jounshenwang/land-air-robot/模型/README.md

# -
面向复杂光伏电站环境，设计集地面行走、空中飞行、组件清洁与红外巡检于一体的陆空两栖机器人。采用陆空复用变构结构，结合PX4、ROS 2及Mid-360激光雷达，基于Nav2实现地面自主导航，基于3D A*实现空中路径规划，提升机器人在复杂环境下的通行与作业能力。
