jounshenwang/land-air-robot/模型/60_16碳纤维管子.SLDPRT

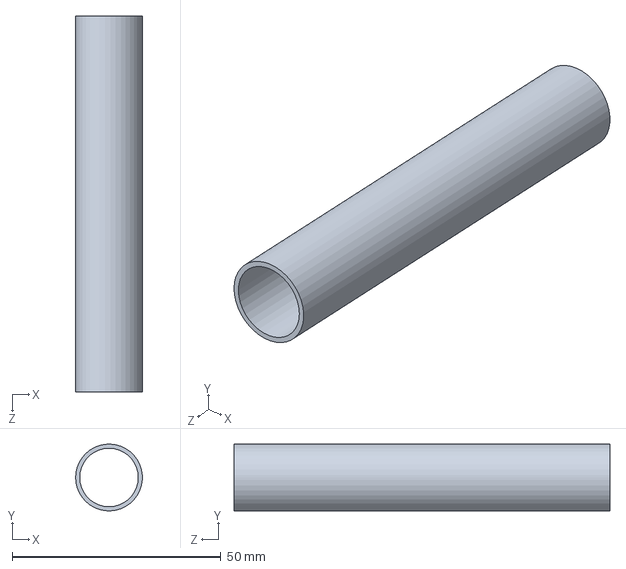
[picture p15: CAD file, 2026-11-09]
模型/60_16碳纤维管子.SLDPRT
16.0 x 16.0 x 90.0 mm
