jounshenwang/land-air-robot/模型/机臂舵机连接.SLDPRT

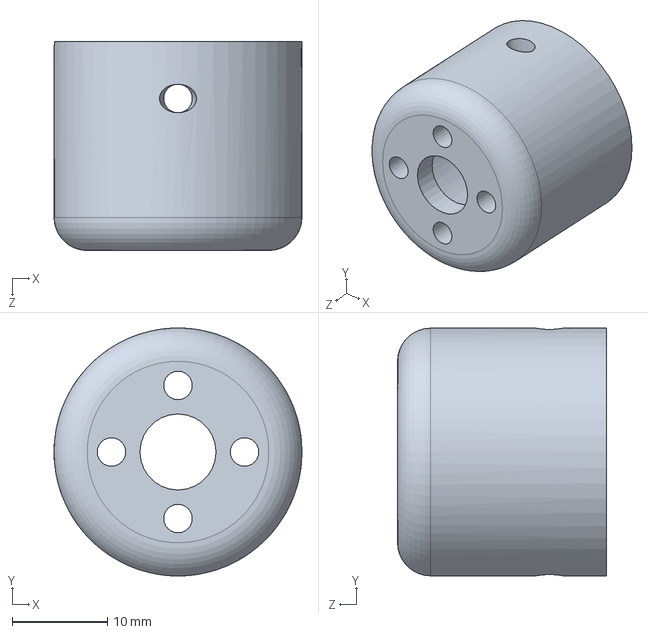
[picture p16: CAD file, 2026-11-09]
模型/机臂舵机连接.SLDPRT
26.1 x 26.1 x 22.0 mm
