jounshenwang/land-air-robot/模型/上脚架.SLDPRT

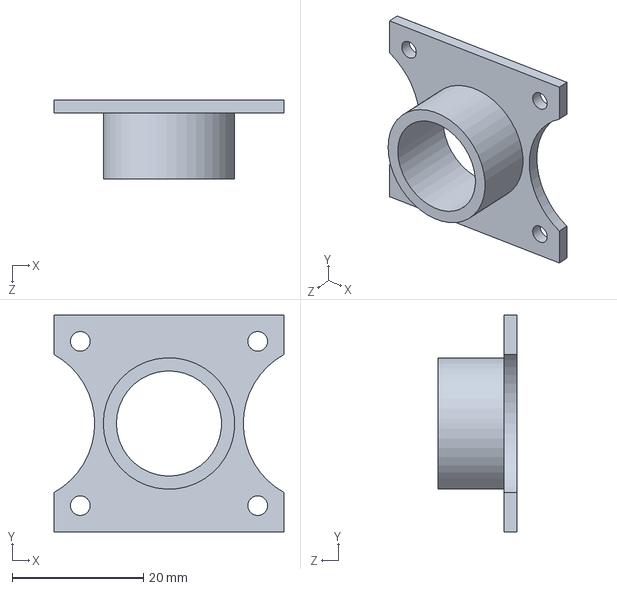
[picture p17: CAD file, 2026-11-09]
模型/上脚架.SLDPRT
35.0 x 33.0 x 12.0 mm
