jounshenwang/land-air-robot/模型/快拆结构.SLDPRT

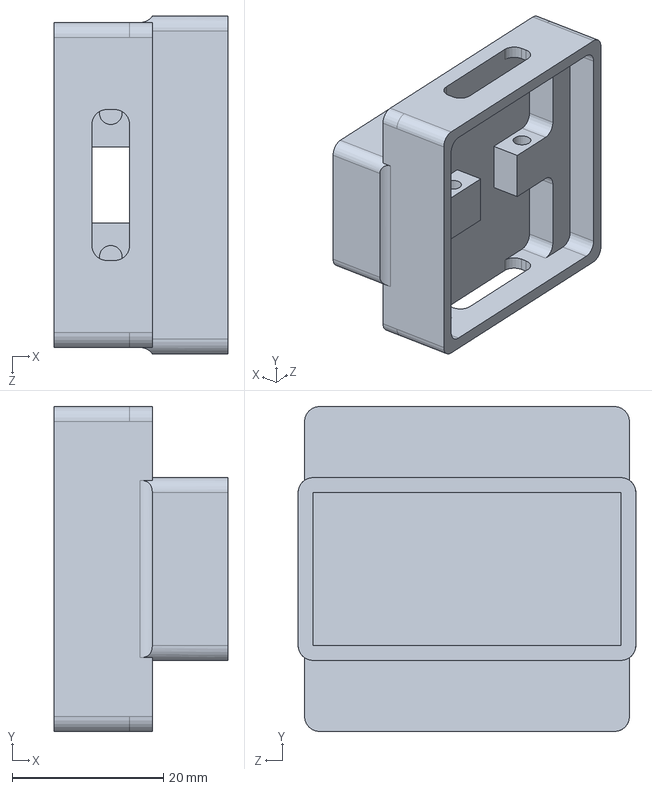
[picture p18: CAD file, 2026-11-09]
模型/快拆结构.SLDPRT
23.0 x 43.0 x 44.7 mm
