jounshenwang/land-air-robot/模型/减速电机底座.SLDPRT

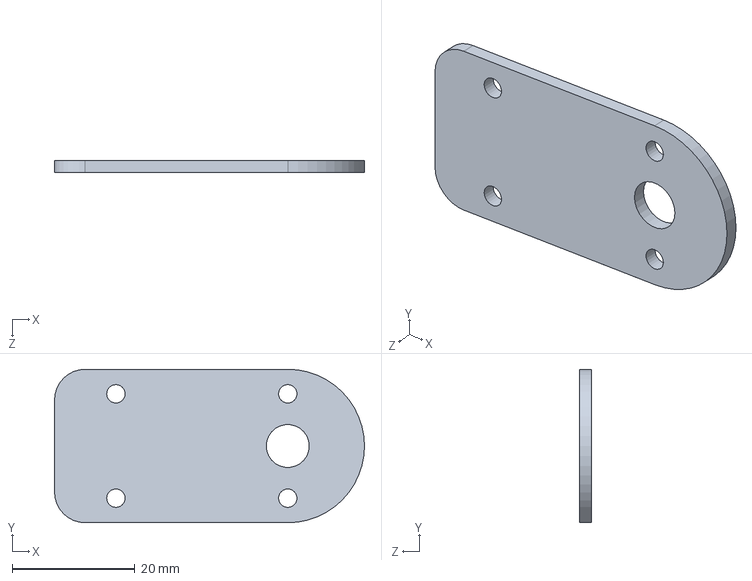
[picture p19: CAD file, 2026-11-09]
模型/减速电机底座.SLDPRT
50.5 x 25.0 x 2.00 mm
