jounshenwang/land-air-robot/模型/11寸桨电机底座.SLDPRT

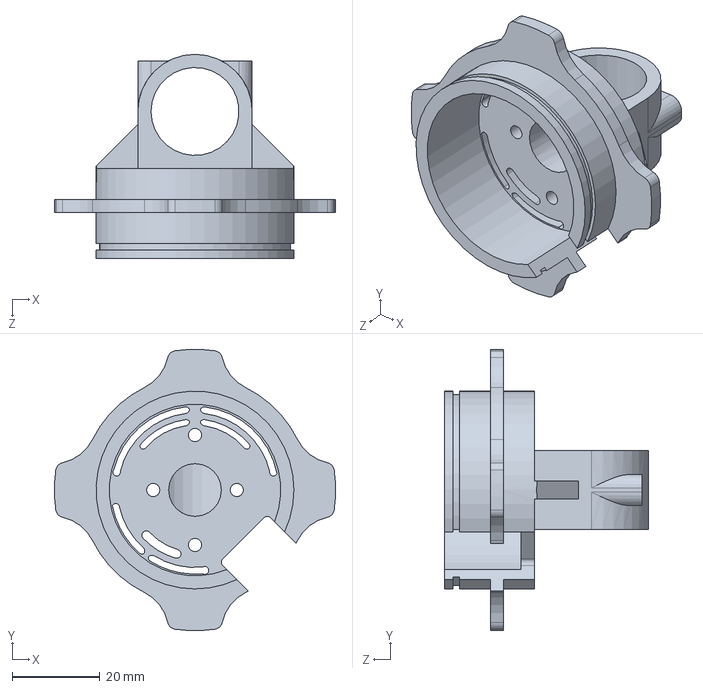
[picture p20: CAD file, 2026-11-09]
模型/11寸桨电机底座.SLDPRT
63.9 x 63.9 x 46.5 mm
