jounshenwang/land-air-robot/模型/机臂固定.SLDPRT

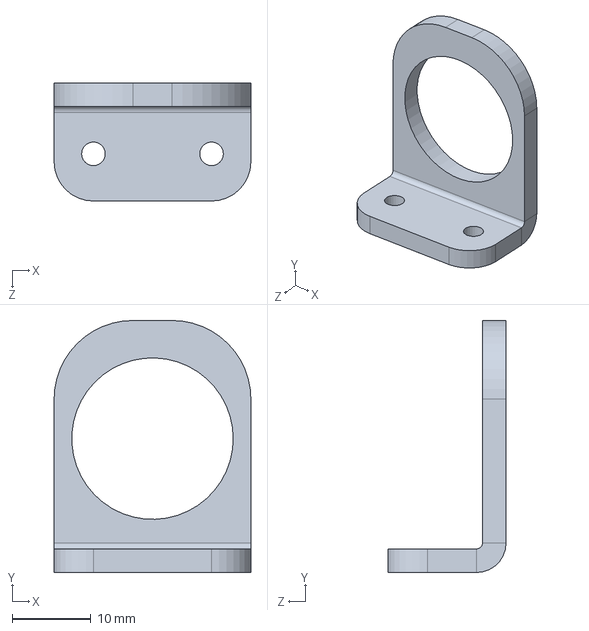
[picture p21: CAD file, 2026-11-09]
模型/机臂固定.SLDPRT
25.0 x 32.0 x 15.0 mm
