jounshenwang/land-air-robot/模型/减震板_下板.SLDPRT

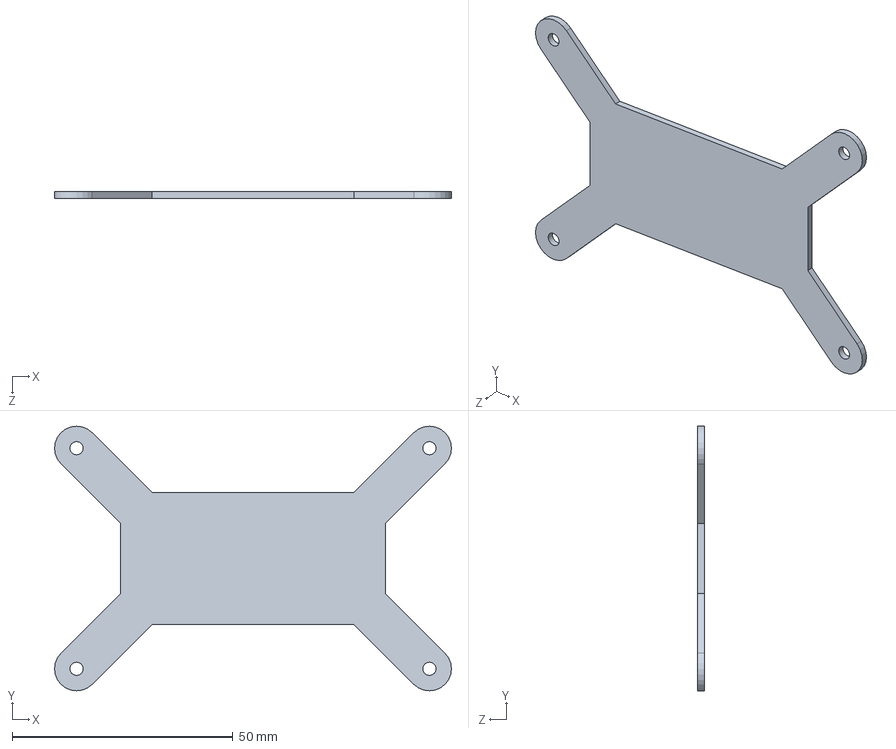
[picture p22: CAD file, 2026-11-09]
模型/减震板_下板.SLDPRT
90.0 x 60.0 x 1.50 mm
