jounshenwang/land-air-robot/模型/窄U支架.SLDPRT

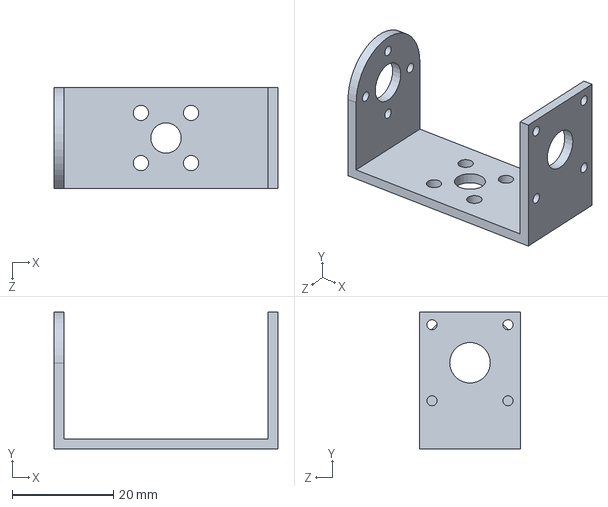
[picture p23: CAD file, 2026-11-09]
模型/窄U支架.SLDPRT
44.2 x 27.0 x 20.0 mm
