jounshenwang/land-air-robot/模型/电池壳.SLDPRT

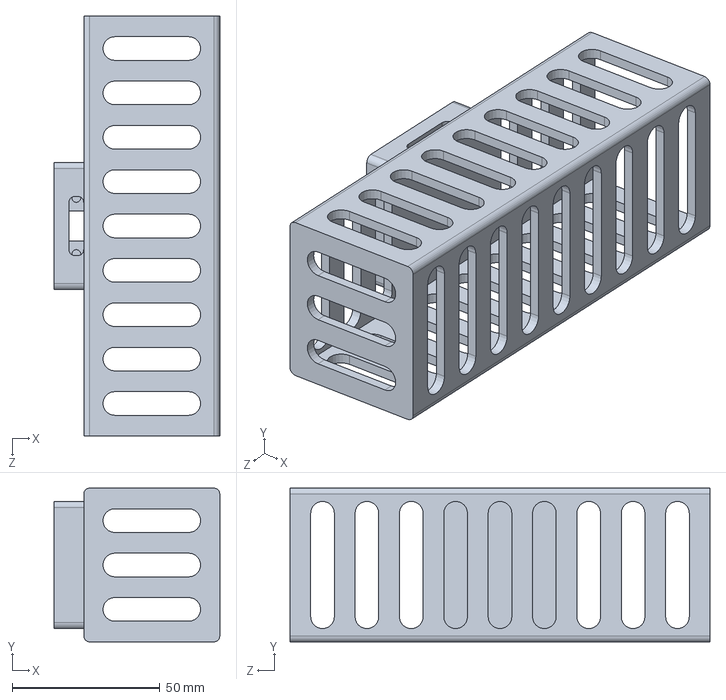
[picture p24: CAD file, 2026-11-09]
模型/电池壳.SLDPRT
56.0 x 52.0 x 142.0 mm
