jounshenwang/land-air-robot/模型/px4模型.SLDPRT

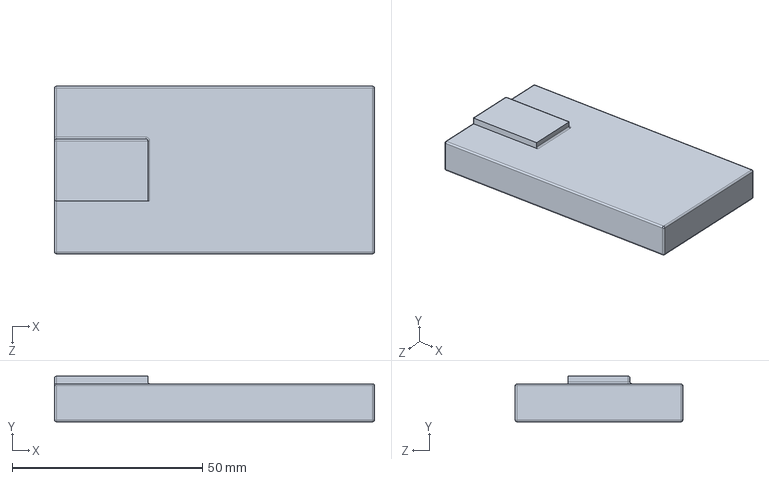
[picture p25: CAD file, 2026-11-09]
模型/px4模型.SLDPRT
84.0 x 12.0 x 44.0 mm
