jounshenwang/land-air-robot/模型/无刷电机.SLDPRT

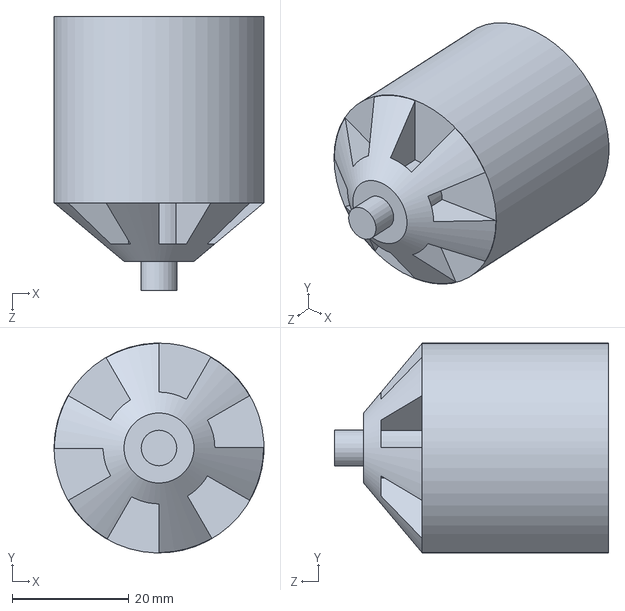
[picture p26: CAD file, 2026-11-09]
模型/无刷电机.SLDPRT
36.0 x 36.0 x 47.0 mm
