jounshenwang/land-air-robot/模型/铜柱3_40.SLDPRT

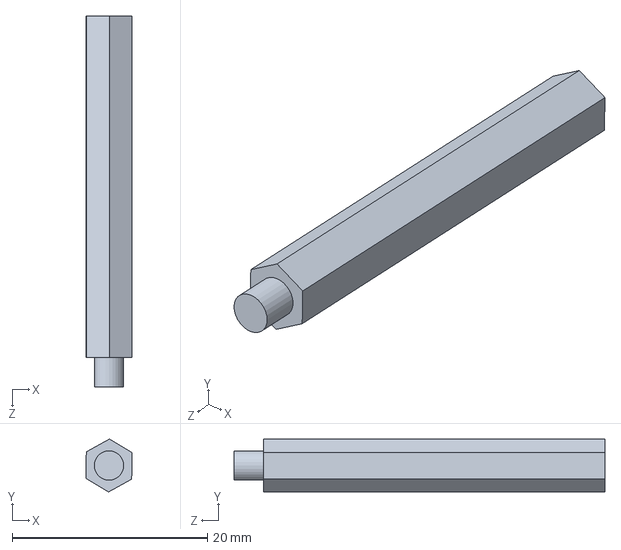
[picture p27: CAD file, 2026-11-09]
模型/铜柱3_40.SLDPRT
4.75 x 5.43 x 38.0 mm
