jounshenwang/land-air-robot/模型/256uvc原装.SLDPRT

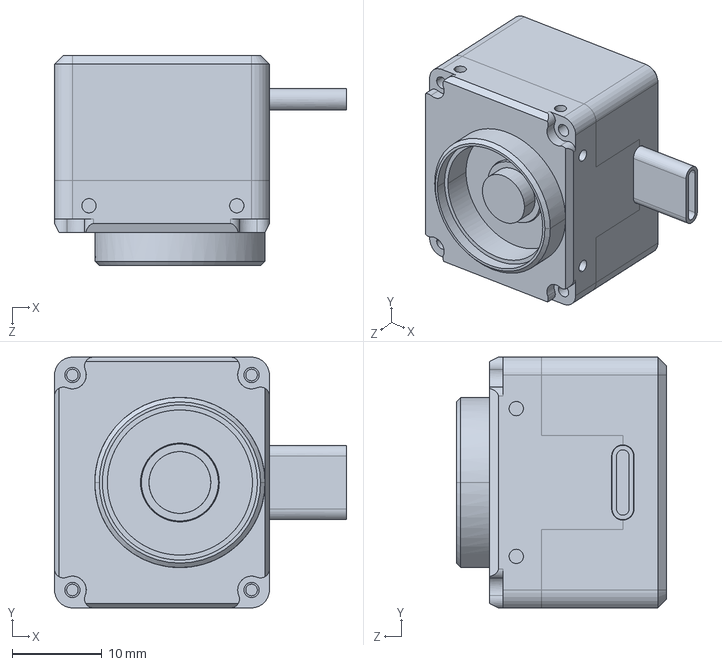
[picture p28: CAD file, 2026-11-09]
模型/256uvc原装.SLDPRT
32.6 x 28.0 x 23.5 mm
