jounshenwang/land-air-robot/模型/摄像头.SLDPRT

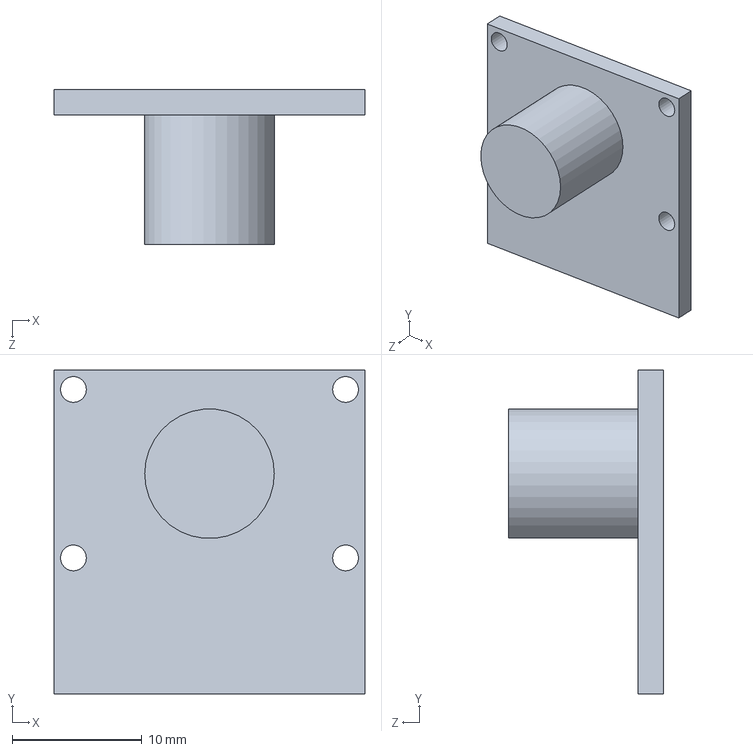
[picture p29: CAD file, 2026-11-09]
模型/摄像头.SLDPRT
24.0 x 25.0 x 12.0 mm
