jounshenwang/land-air-robot/模型/快拆上板.SLDPRT

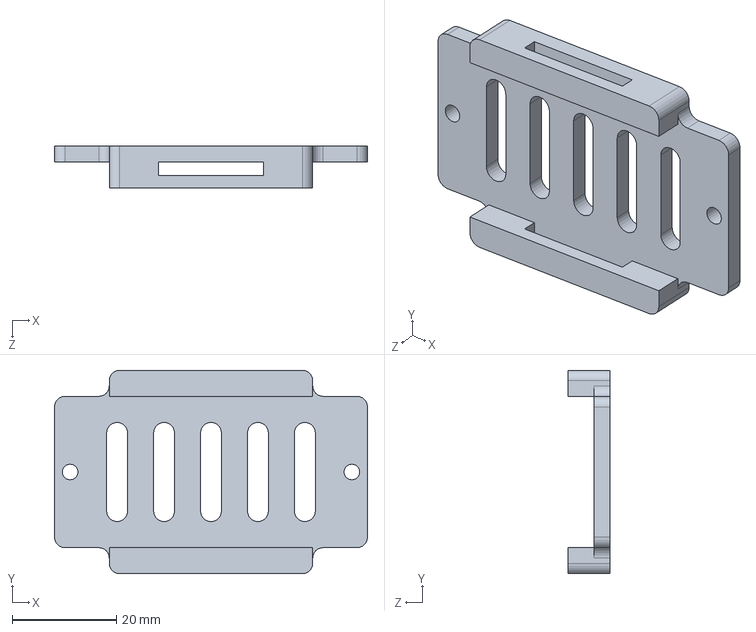
[picture p30: CAD file, 2026-11-09]
模型/快拆上板.SLDPRT
60.0 x 39.0 x 8.00 mm
