jounshenwang/land-air-robot/模型/滚筒.SLDPRT

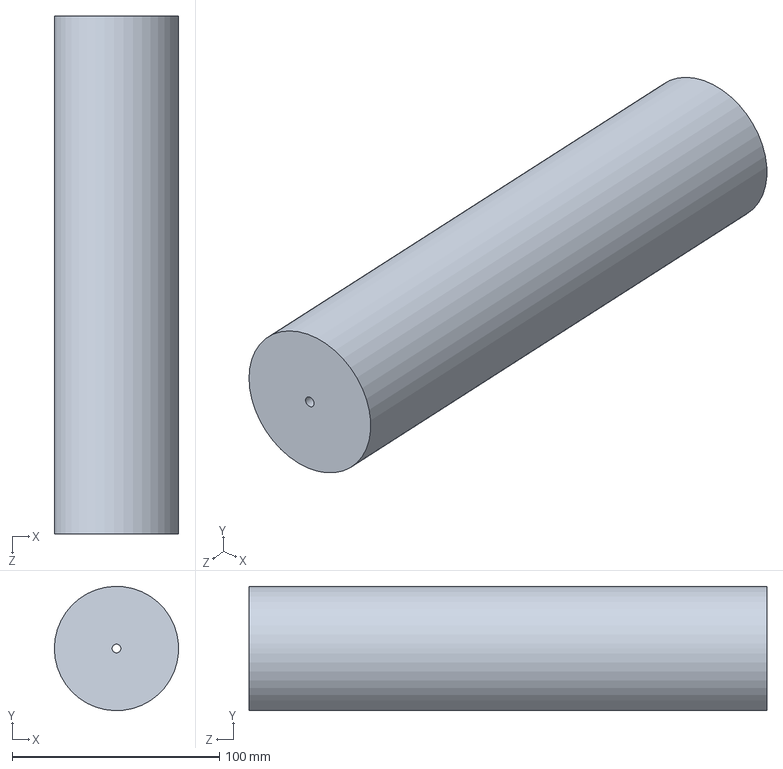
[picture p31: CAD file, 2026-11-09]
模型/滚筒.SLDPRT
60.0 x 60.0 x 250.0 mm
