jounshenwang/land-air-robot/模型/圆柱齿轮21×1.SLDPRT

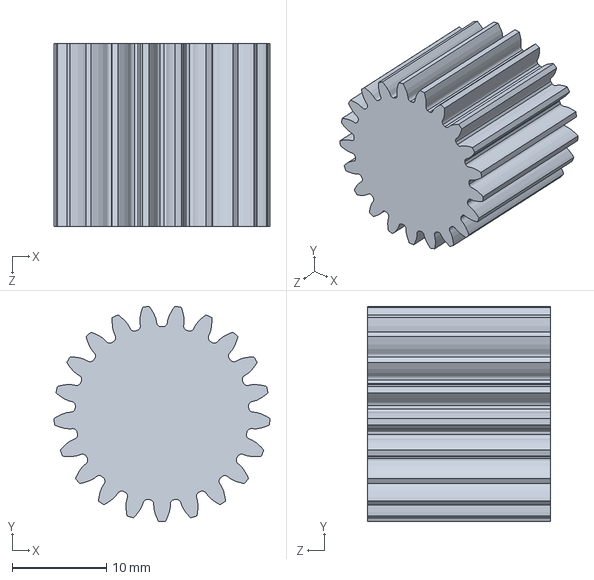
[picture p32: CAD file, 2026-11-09]
模型/圆柱齿轮21×1.SLDPRT
23.0 x 22.9 x 19.5 mm
