jounshenwang/land-air-robot/模型/双轴15-35KG舵机.SLDPRT

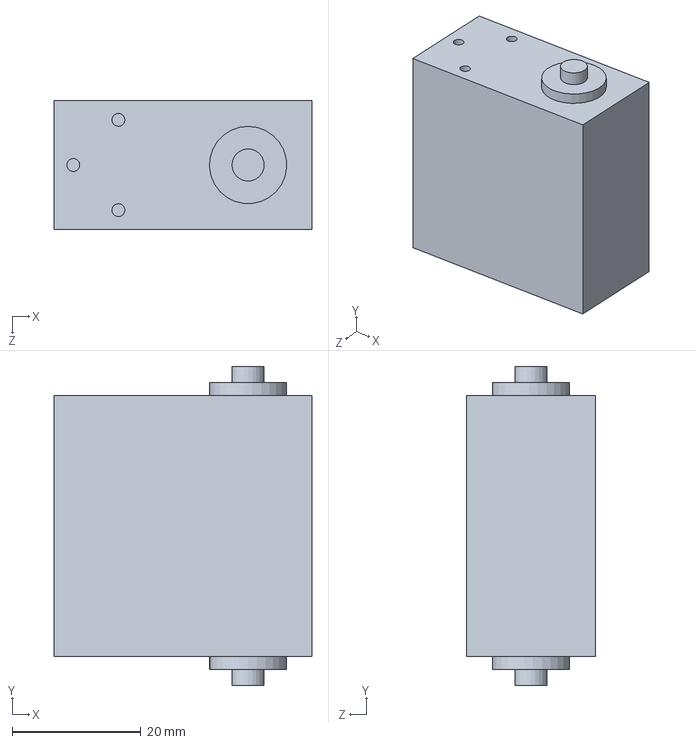
[picture p33: CAD file, 2026-11-09]
模型/双轴15-35KG舵机.SLDPRT
40.0 x 49.5 x 20.0 mm
