jounshenwang/land-air-robot/模型/支架.SLDPRT

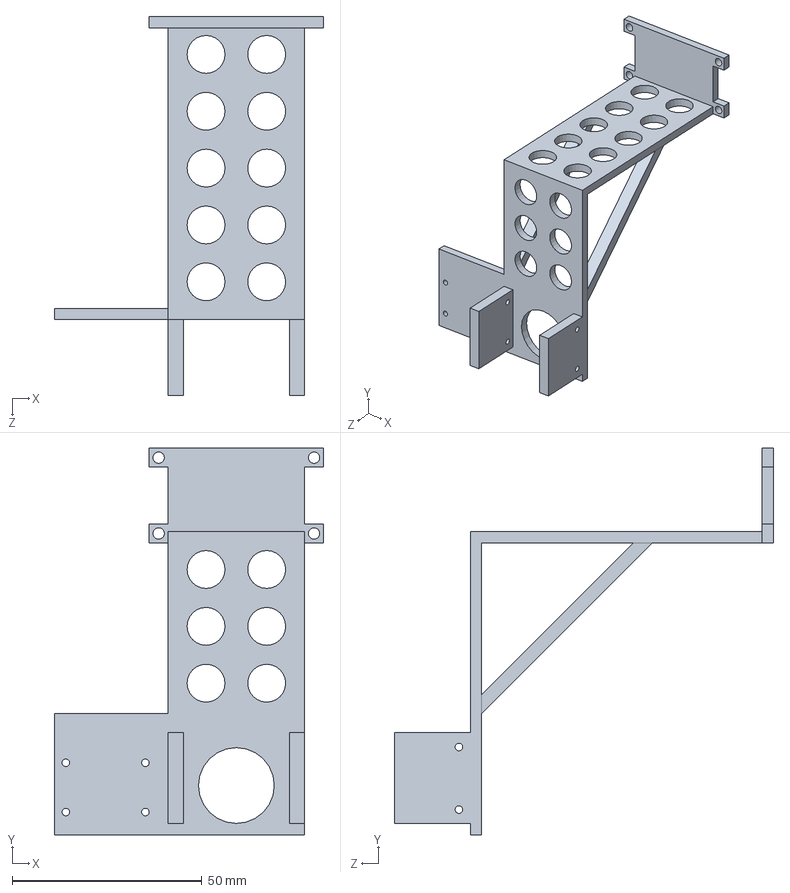
[picture p34: CAD file, 2026-11-09]
模型/支架.SLDPRT
71.0 x 102.0 x 100.0 mm
