jounshenwang/land-air-robot/模型/机臂.SLDPRT

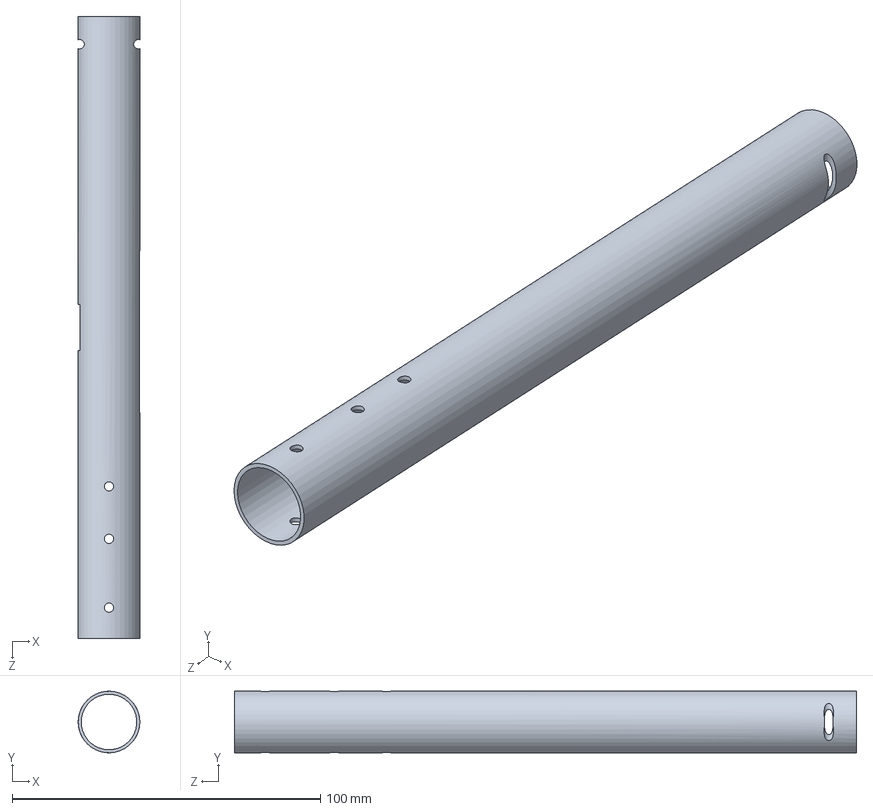
[picture p35: CAD file, 2026-11-09]
模型/机臂.SLDPRT
20.0 x 20.0 x 201.8 mm
