jounshenwang/land-air-robot/模型/jetson底板.SLDPRT

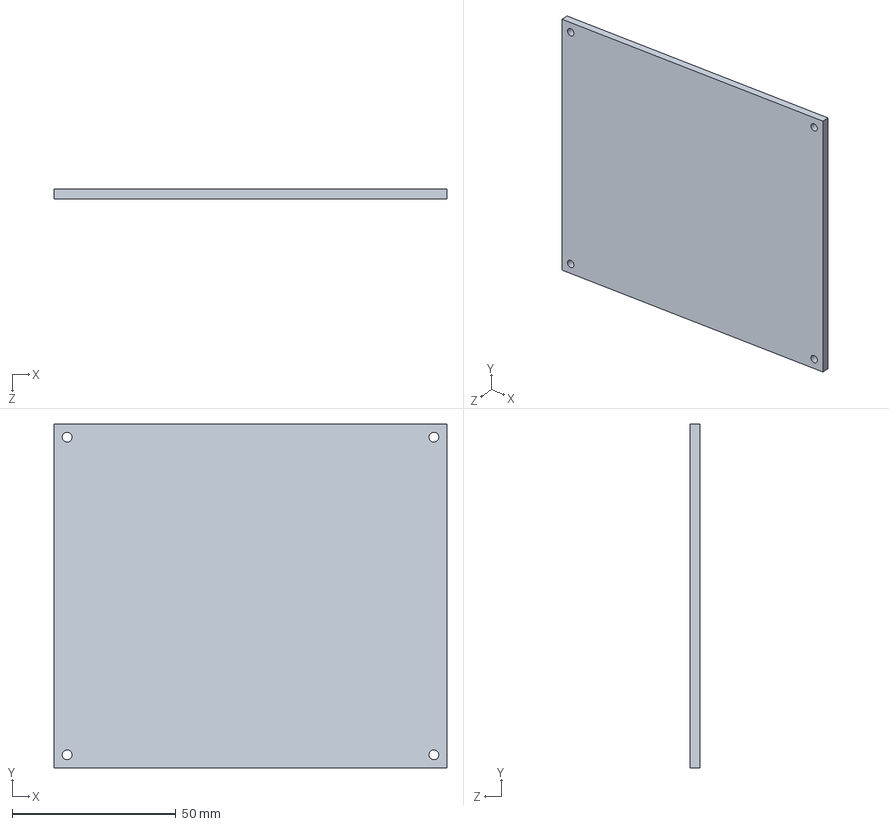
[picture p36: CAD file, 2026-11-09]
模型/jetson底板.SLDPRT
120.0 x 105.0 x 3.00 mm
