jounshenwang/land-air-robot/模型/镂空上板.SLDPRT

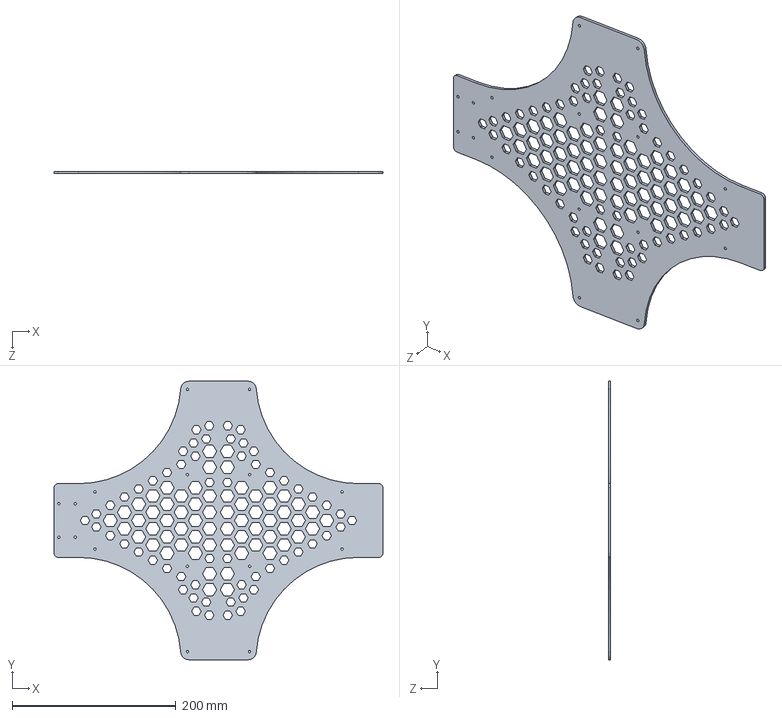
[picture p37: CAD file, 2026-11-09]
模型/镂空上板.SLDPRT
401.6 x 340.0 x 3.00 mm
