jounshenwang/land-air-robot/模型/圆柱齿轮24×1.SLDPRT

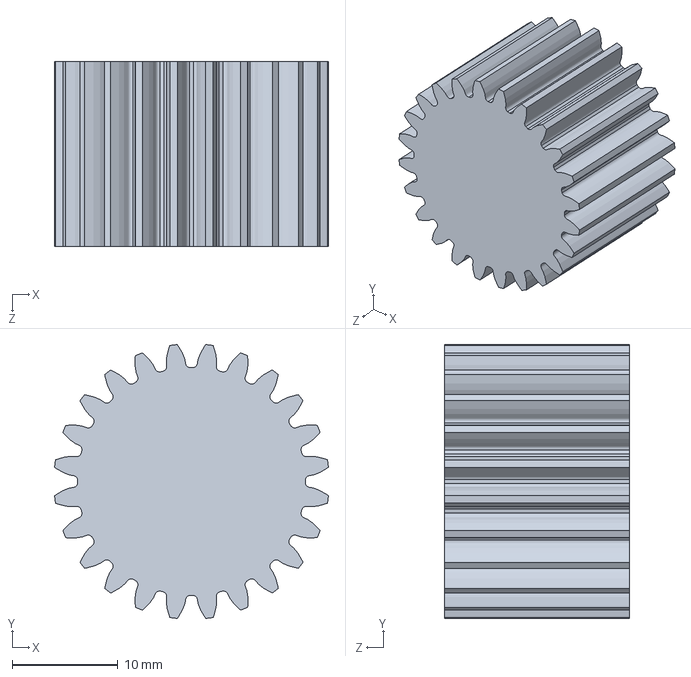
[picture p38: CAD file, 2026-11-09]
模型/圆柱齿轮24×1.SLDPRT
25.9 x 25.9 x 17.5 mm
