jounshenwang/land-air-robot/模型/jetson上版.SLDPRT

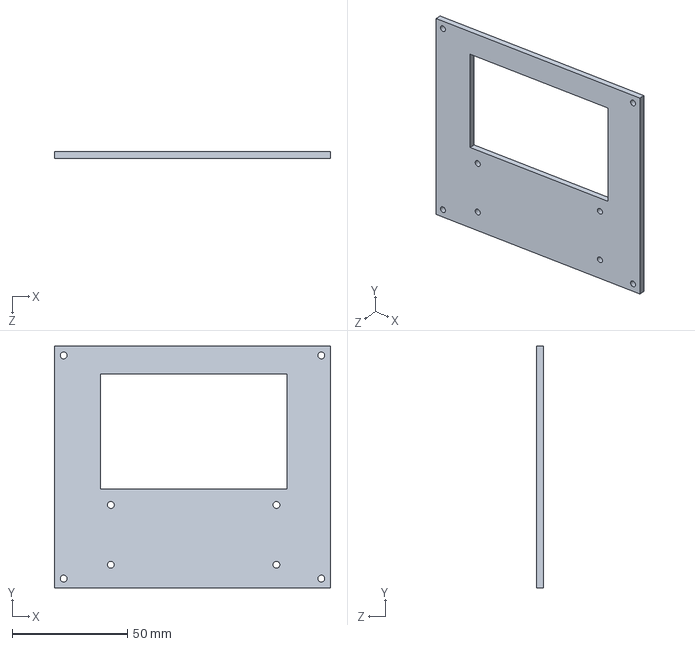
[picture p39: CAD file, 2026-11-09]
模型/jetson上版.SLDPRT
120.0 x 105.0 x 3.00 mm
