jounshenwang/land-air-robot/模型/上板.SLDPRT

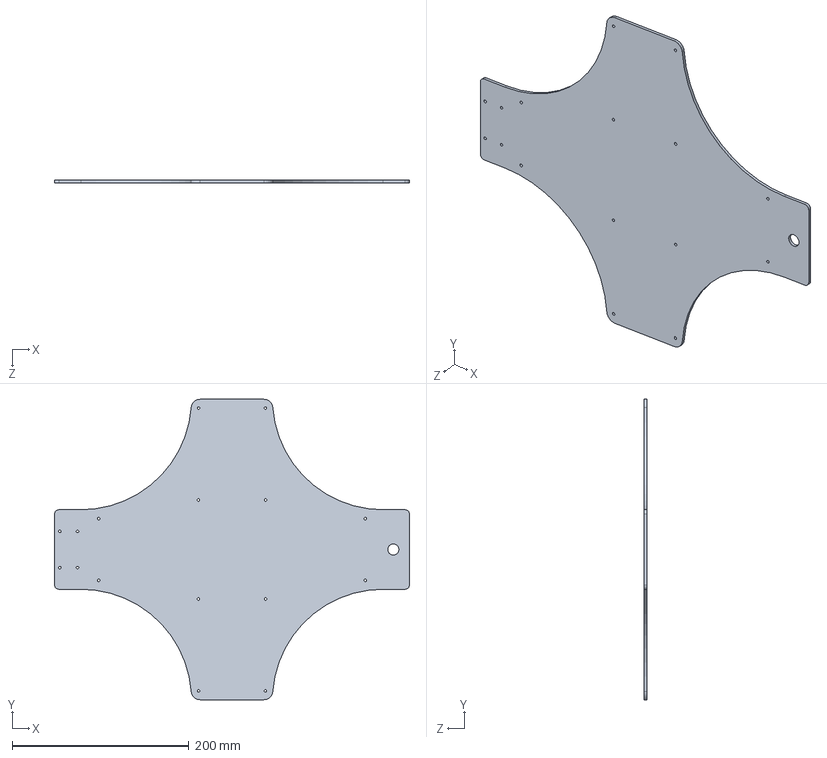
[picture p40: CAD file, 2026-11-09]
模型/上板.SLDPRT
401.6 x 340.0 x 3.00 mm
