jounshenwang/land-air-robot/模型/底部架子.SLDPRT

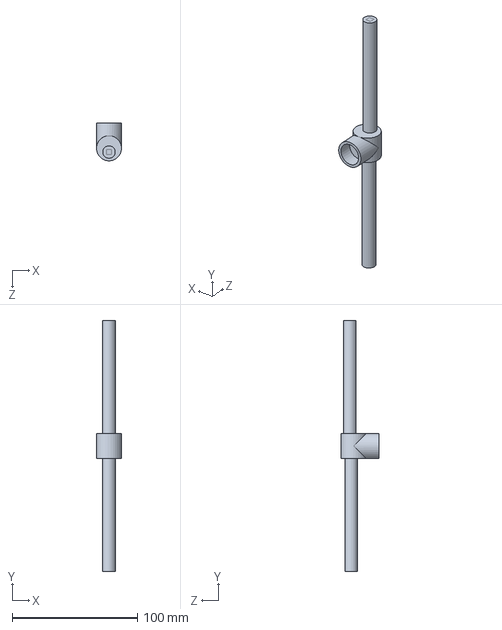
[picture p41: CAD file, 2026-11-09]
模型/底部架子.SLDPRT
20.0 x 200.1 x 29.9 mm
