jounshenwang/land-air-robot/模型/11寸底板.SLDPRT

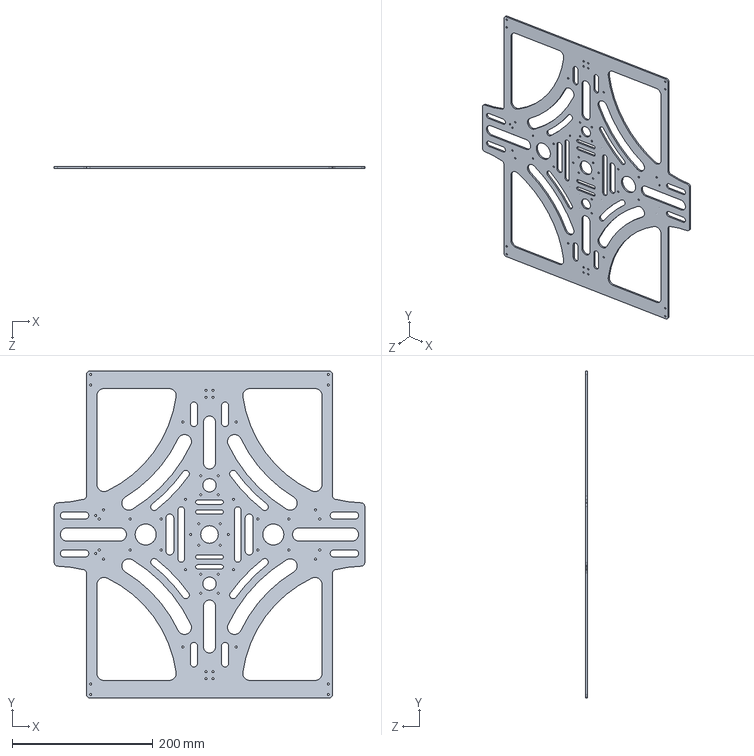
[picture p42: CAD file, 2026-11-09]
模型/11寸底板.SLDPRT
441.6 x 465.0 x 3.00 mm
