jounshenwang/land-air-robot/模型/铜柱3_5.SLDPRT

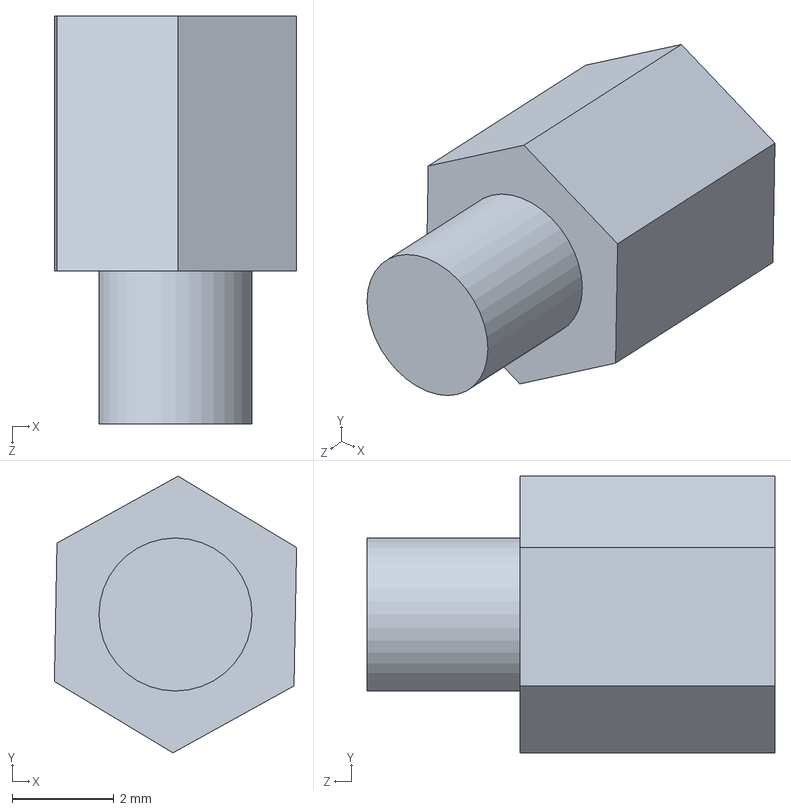
[picture p43: CAD file, 2026-11-09]
模型/铜柱3_5.SLDPRT
4.75 x 5.43 x 8.00 mm
