jounshenwang/land-air-robot/模型/虚轴舵盘.SLDPRT

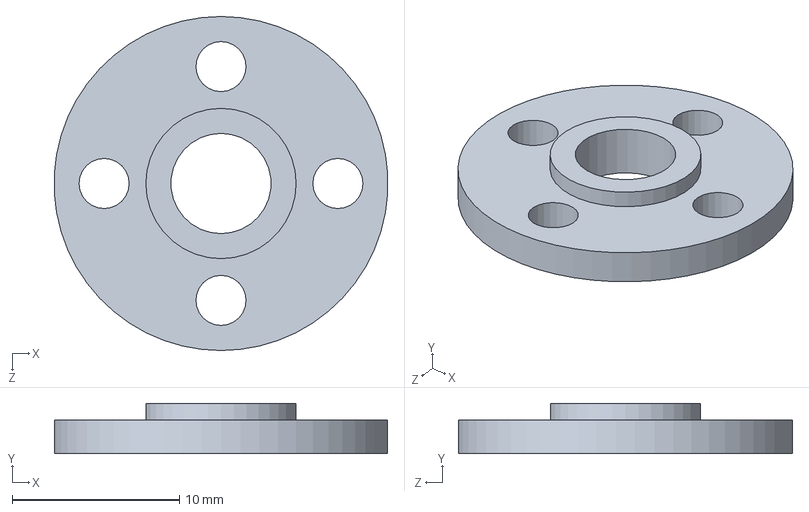
[picture p44: CAD file, 2026-11-09]
模型/虚轴舵盘.SLDPRT
20.0 x 3.00 x 20.0 mm
