jounshenwang/land-air-robot/模型/快拆部件_弹簧4_0.3_25.SLDPRT

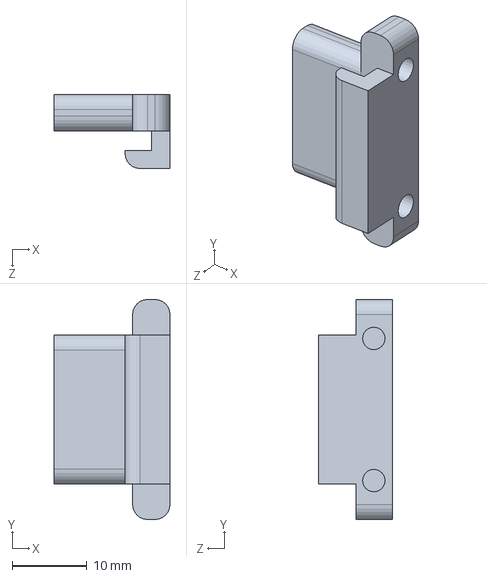
[picture p45: CAD file, 2026-11-09]
模型/快拆部件_弹簧4_0.3_25.SLDPRT
15.5 x 29.4 x 9.90 mm
