jounshenwang/land-air-robot/模型/舵盘支架.SLDPRT

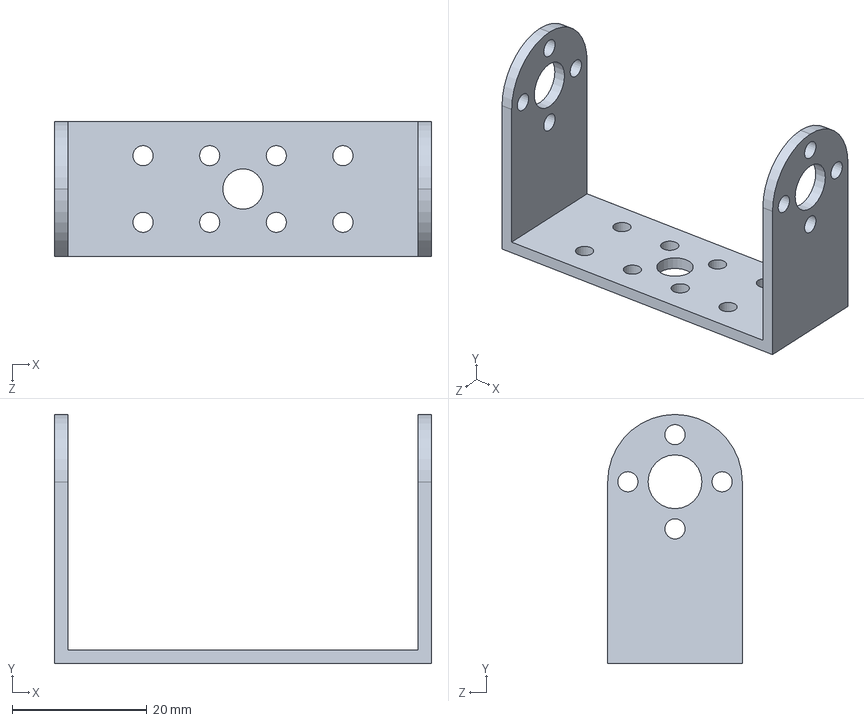
[picture p46: CAD file, 2026-11-09]
模型/舵盘支架.SLDPRT
56.0 x 37.0 x 20.0 mm
