jounshenwang/land-air-robot/模型/四路电机驱动板SLDPRT.SLDPRT

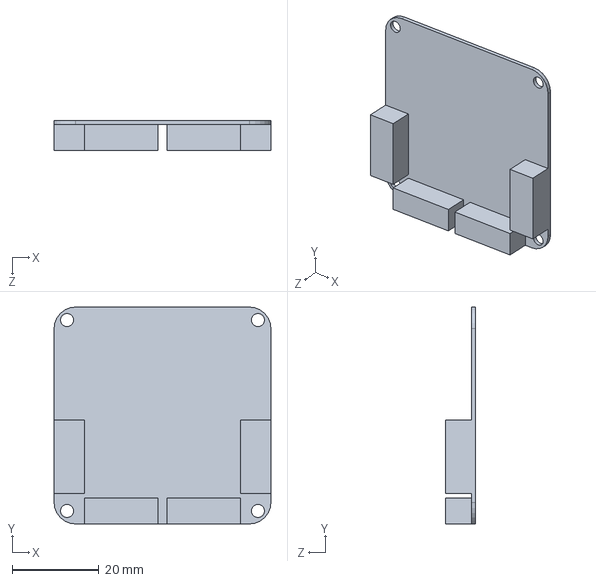
[picture p47: CAD file, 2026-11-09]
模型/四路电机驱动板SLDPRT.SLDPRT
50.0 x 50.0 x 7.00 mm
