jounshenwang/land-air-robot/模型/m3螺帽.SLDPRT

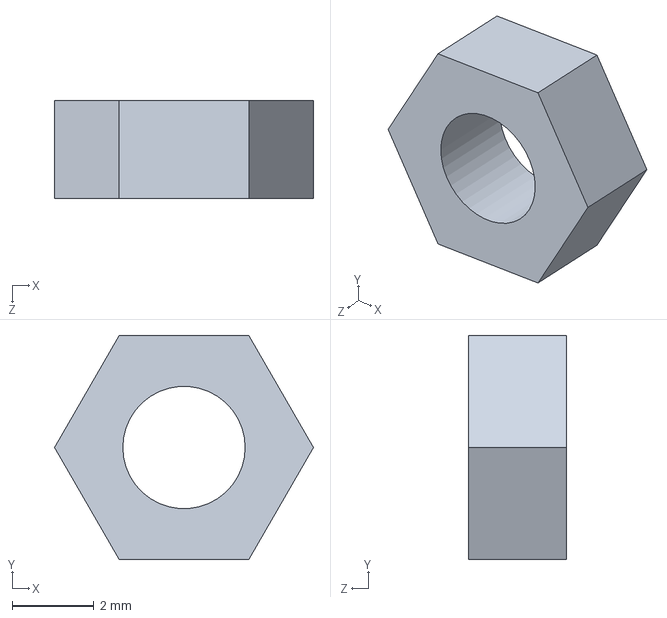
[picture p48: CAD file, 2026-11-09]
模型/m3螺帽.SLDPRT
6.35 x 5.50 x 2.40 mm
