jounshenwang/land-air-robot/模型/fai22卡簧.SLDPRT

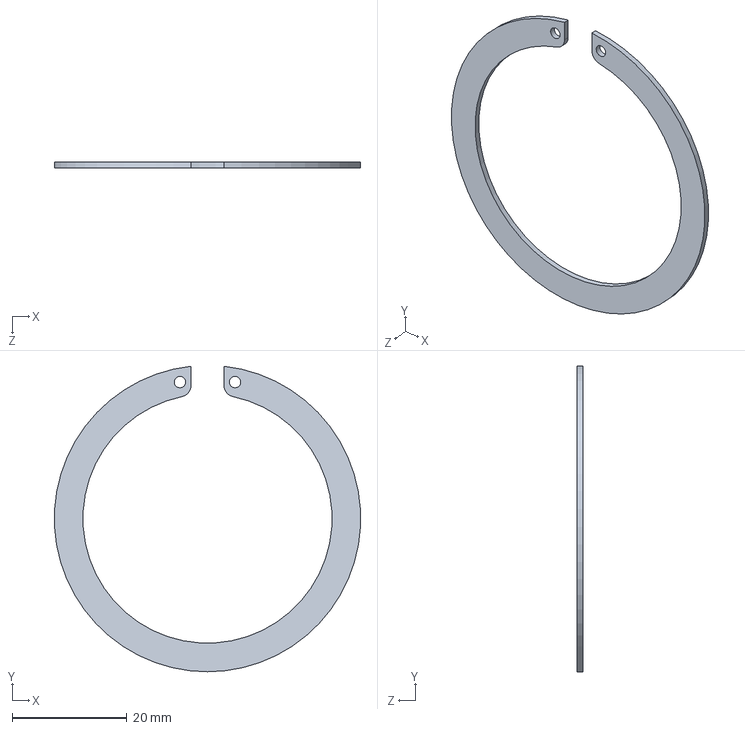
[picture p49: CAD file, 2026-11-09]
模型/fai22卡簧.SLDPRT
53.4 x 53.3 x 1.00 mm
