jounshenwang/land-air-robot/模型/脚架海绵套.SLDPRT

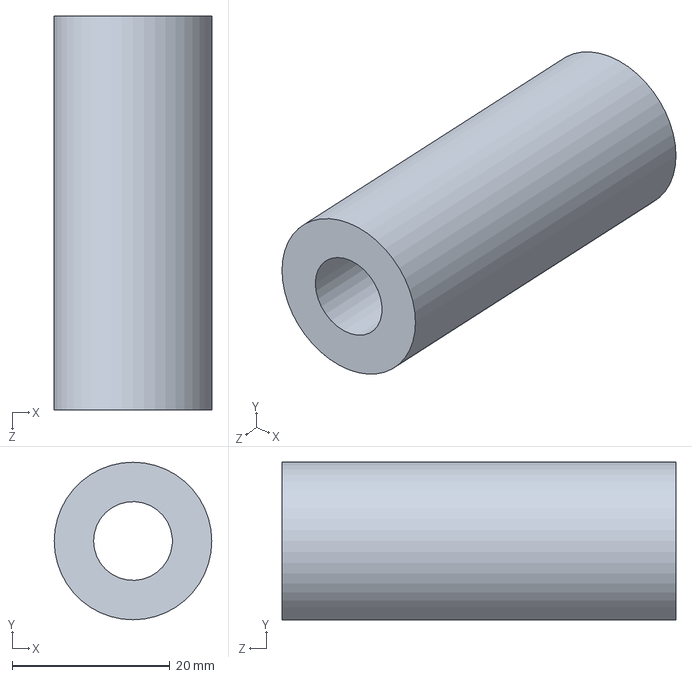
[picture p50: CAD file, 2026-11-09]
模型/脚架海绵套.SLDPRT
20.0 x 20.0 x 50.0 mm
