jounshenwang/land-air-robot/模型/3300电池.SLDPRT

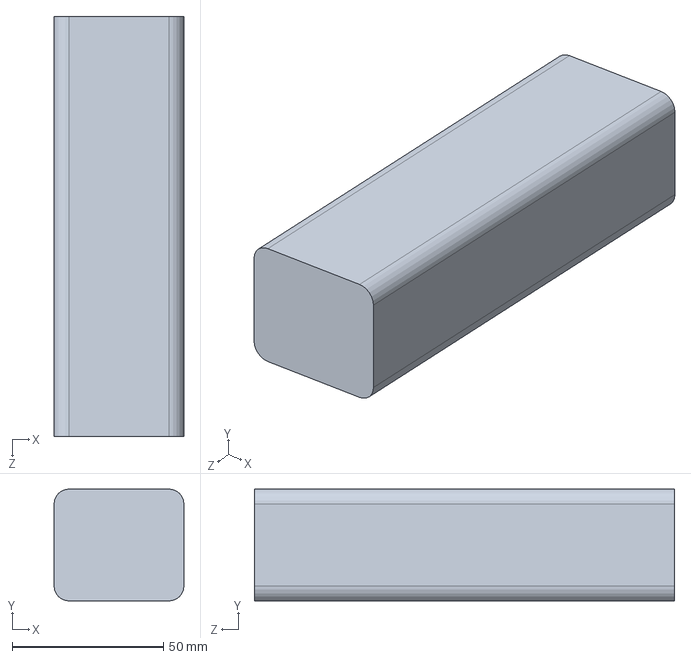
[picture p51: CAD file, 2026-11-09]
模型/3300电池.SLDPRT
43.0 x 37.0 x 139.0 mm
