jounshenwang/land-air-robot/模型/937rpm电机.SLDPRT

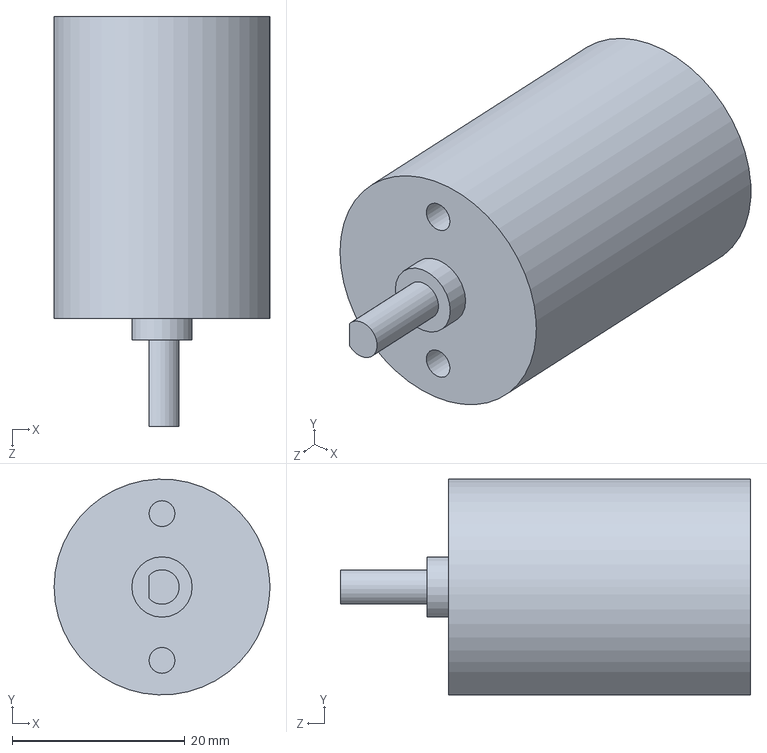
[picture p52: CAD file, 2026-11-09]
模型/937rpm电机.SLDPRT
25.0 x 25.0 x 47.5 mm
