jounshenwang/land-air-robot/模型/分电板_24v_8-12v.SLDPRT

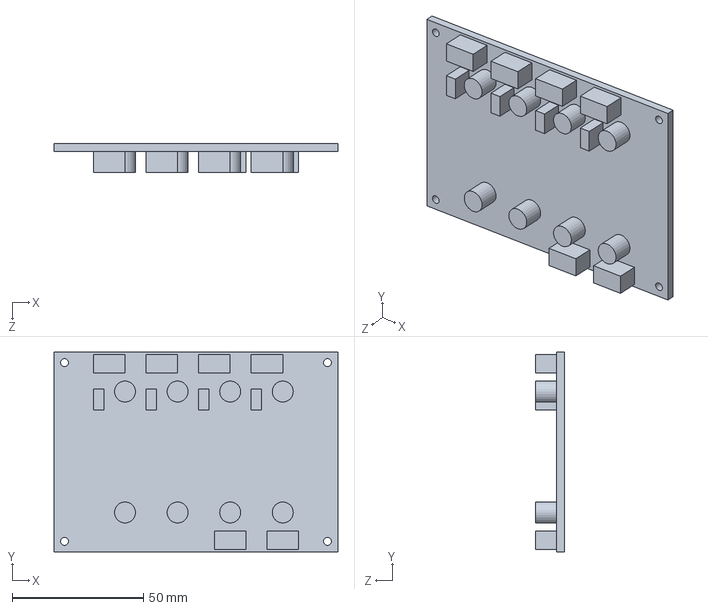
[picture p53: CAD file, 2026-11-09]
模型/分电板_24v_8-12v.SLDPRT
108.0 x 76.0 x 11.0 mm
