jounshenwang/land-air-robot/模型/圆柱齿轮288×1.SLDPRT

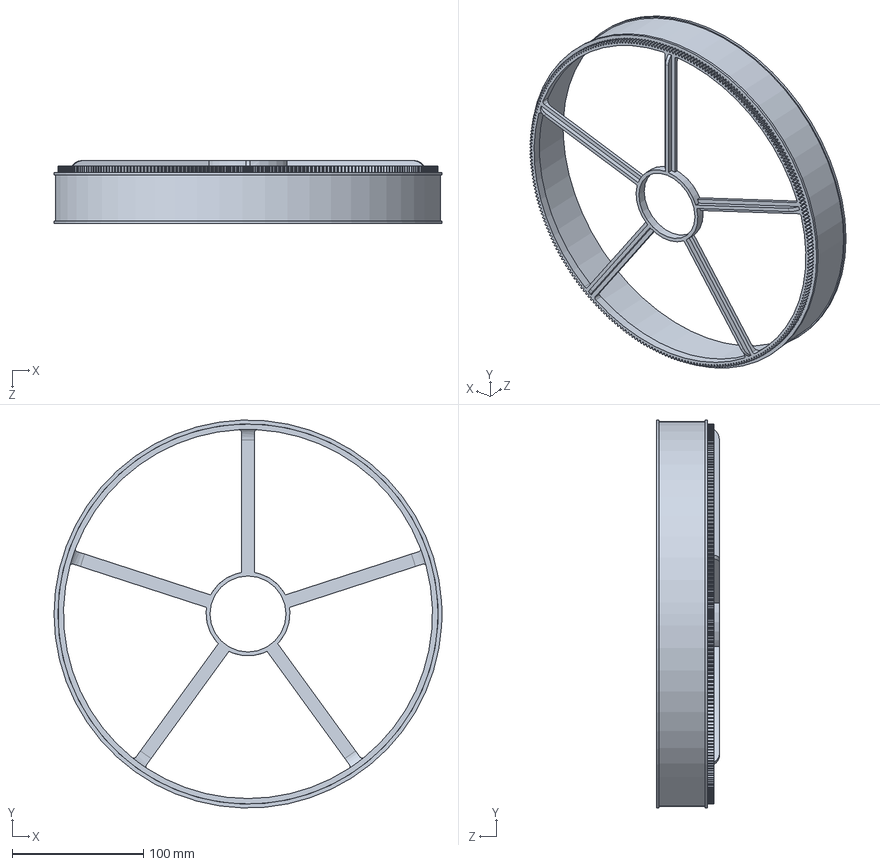
[picture p54: CAD file, 2026-11-09]
模型/圆柱齿轮288×1.SLDPRT
296.0 x 295.9 x 48.0 mm
