jounshenwang/land-air-robot/模型/雷达架子_7.13.SLDPRT

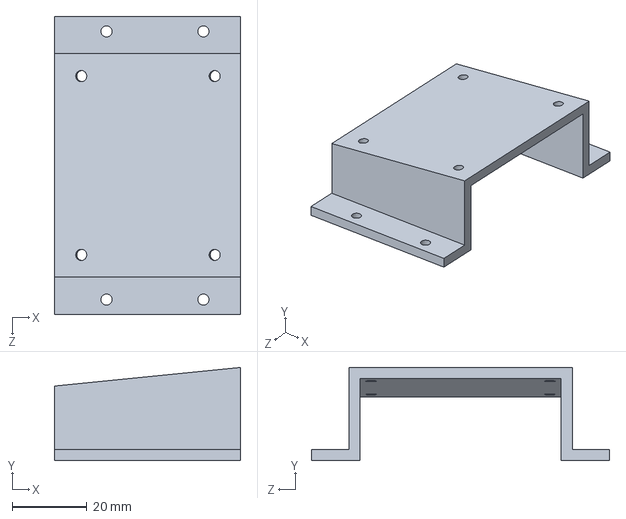
[picture p55: CAD file, 2026-11-09]
模型/雷达架子_7.13.SLDPRT
50.0 x 25.0 x 80.0 mm
