jounshenwang/land-air-robot/模型/铜柱m3_35_3.SLDPRT

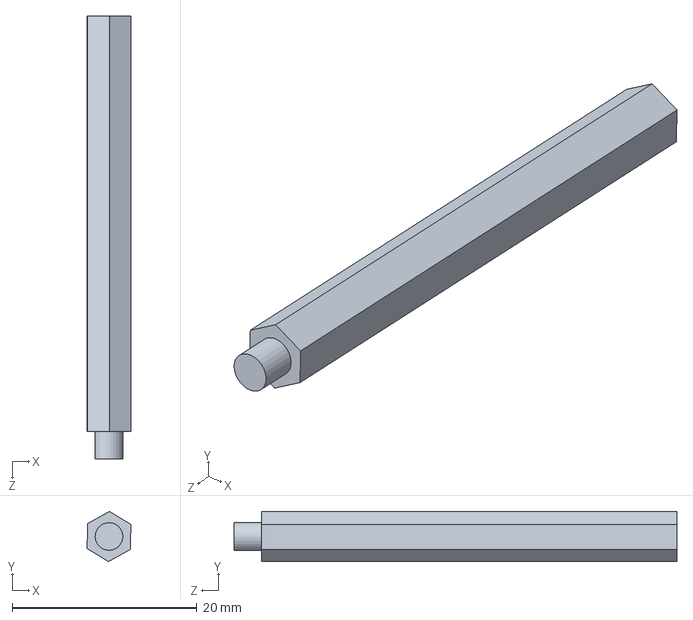
[picture p56: CAD file, 2026-11-09]
模型/铜柱m3_35_3.SLDPRT
4.75 x 5.43 x 48.0 mm
