jounshenwang/land-air-robot/模型/圆柱齿轮22×1.SLDPRT

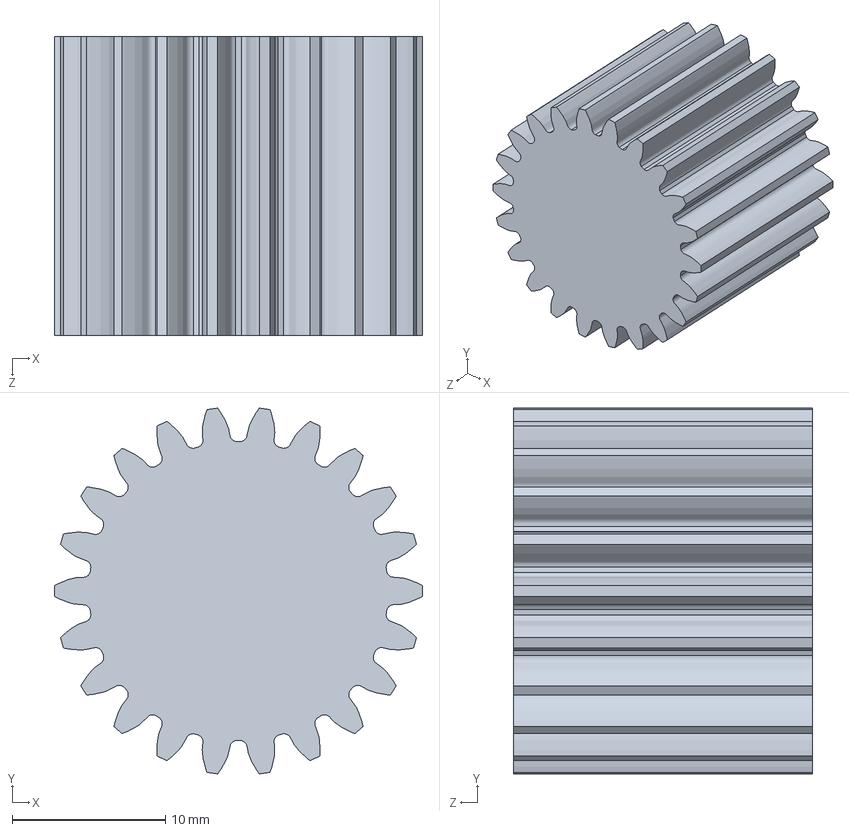
[picture p57: CAD file, 2026-11-09]
模型/圆柱齿轮22×1.SLDPRT
24.0 x 23.8 x 19.5 mm
