jounshenwang/land-air-robot/模型/铜柱3_15.SLDPRT

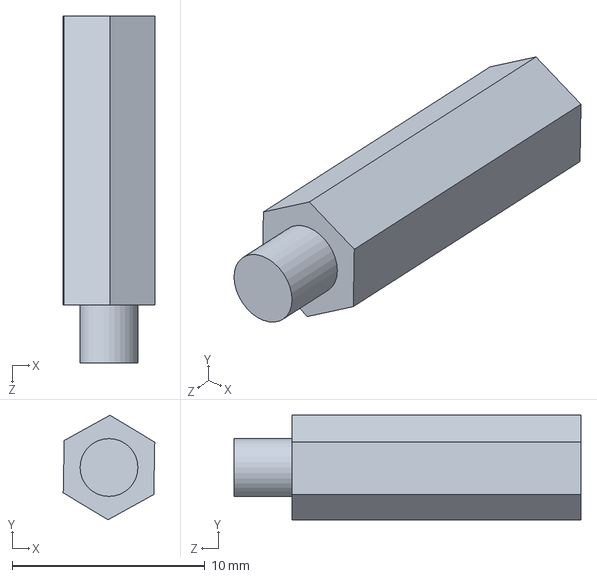
[picture p58: CAD file, 2026-11-09]
模型/铜柱3_15.SLDPRT
4.75 x 5.43 x 18.0 mm
