jounshenwang/land-air-robot/模型/jetson nano盒子.SLDPRT

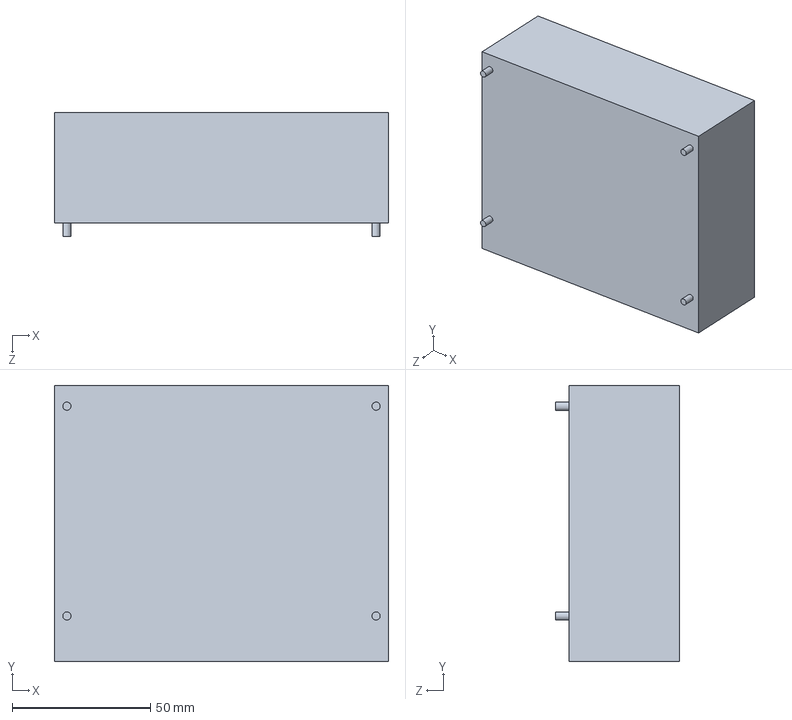
[picture p59: CAD file, 2026-11-09]
模型/jetson nano盒子.SLDPRT
121.0 x 100.0 x 45.0 mm
