jounshenwang/land-air-robot/模型/两个6809.SLDPRT

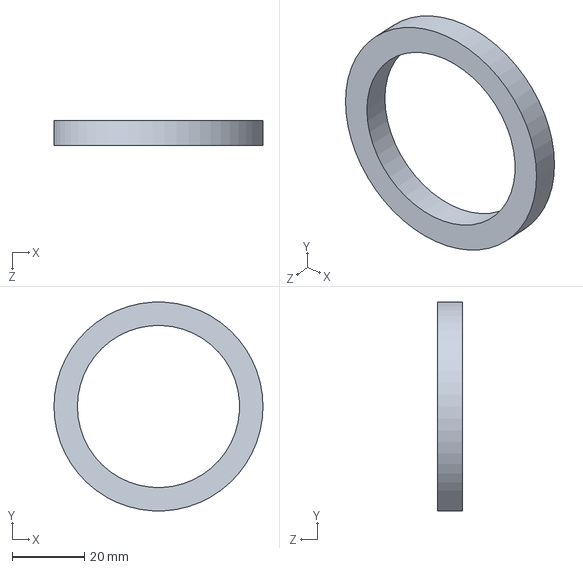
[picture p60: CAD file, 2026-11-09]
模型/两个6809.SLDPRT
58.0 x 57.9 x 7.00 mm
