jounshenwang/land-air-robot/模型/电调.SLDPRT

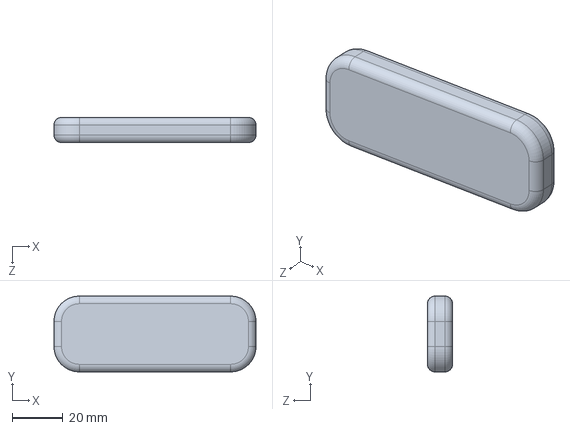
[picture p61: CAD file, 2026-11-09]
模型/电调.SLDPRT
80.0 x 30.0 x 10.0 mm
