jounshenwang/land-air-robot/模型/圆柱齿轮20×1.SLDPRT

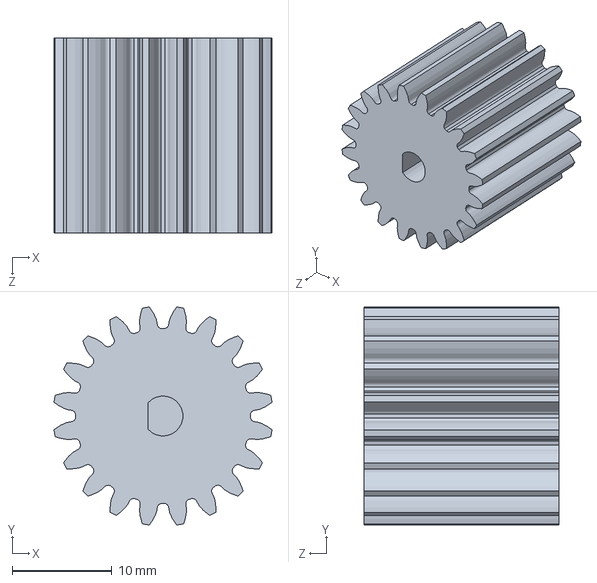
[picture p62: CAD file, 2026-11-09]
模型/圆柱齿轮20×1.SLDPRT
21.8 x 21.8 x 19.5 mm
