jounshenwang/land-air-robot/模型/实轴舵盘.SLDPRT

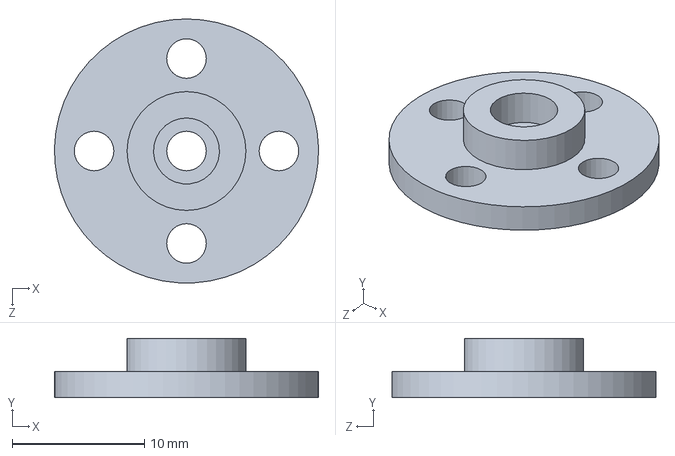
[picture p63: CAD file, 2026-11-09]
模型/实轴舵盘.SLDPRT
20.0 x 4.50 x 20.0 mm
