jounshenwang/land-air-robot/模型/无刷电机底座.SLDPRT

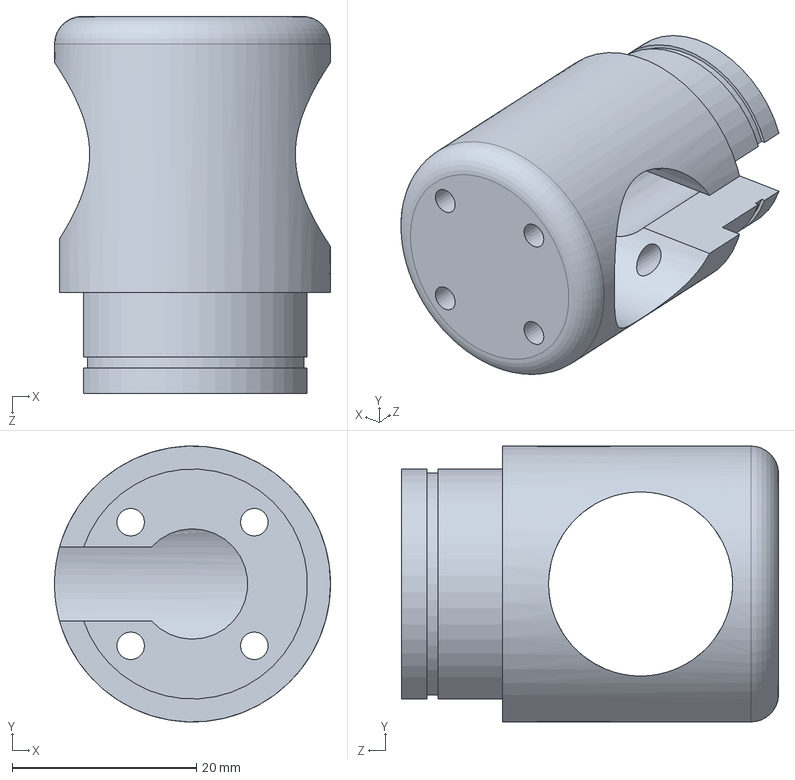
[picture p64: CAD file, 2026-11-09]
模型/无刷电机底座.SLDPRT
30.0 x 30.0 x 41.0 mm
