jounshenwang/land-air-robot/模型/GEMFAN 11x4.7.SLDPRT

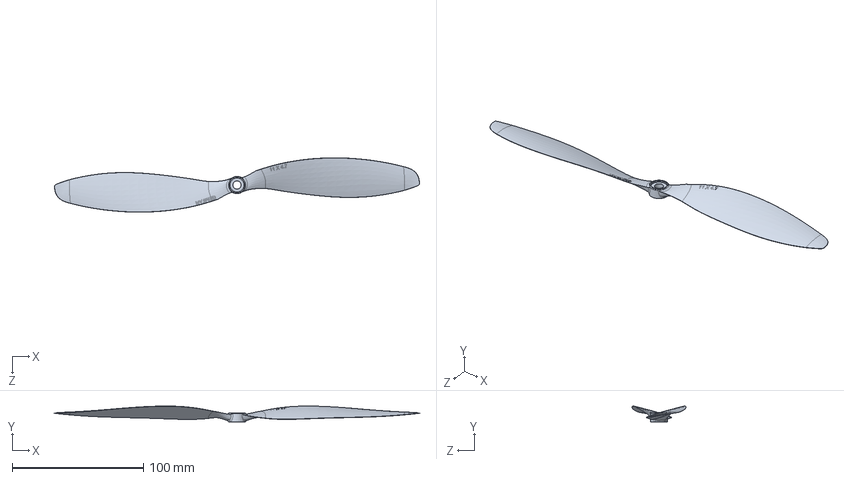
[picture p65: CAD file, 2026-11-09]
模型/GEMFAN 11x4.7.SLDPRT
278.4 x 12.1 x 41.5 mm
