jounshenwang/land-air-robot/模型/雷达架子.SLDPRT

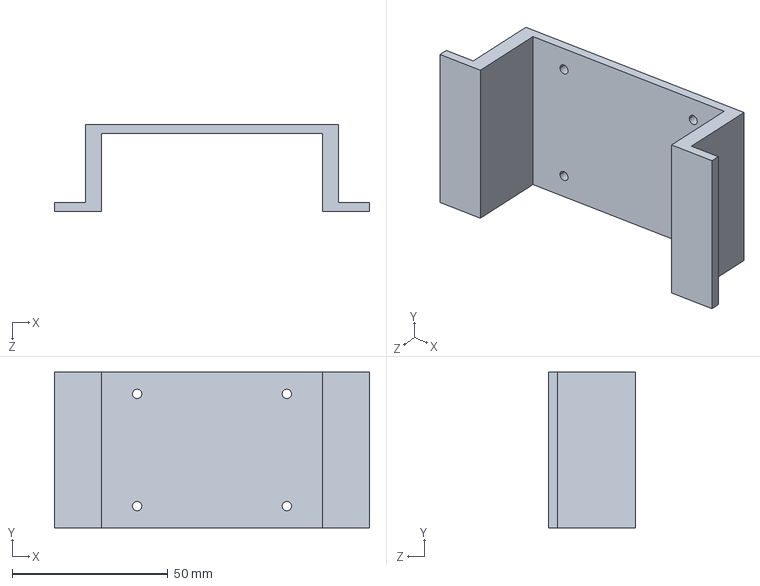
[picture p66: CAD file, 2026-11-09]
模型/雷达架子.SLDPRT
101.0 x 50.0 x 28.0 mm
