jounshenwang/land-air-robot/模型/长条手.SLDPRT

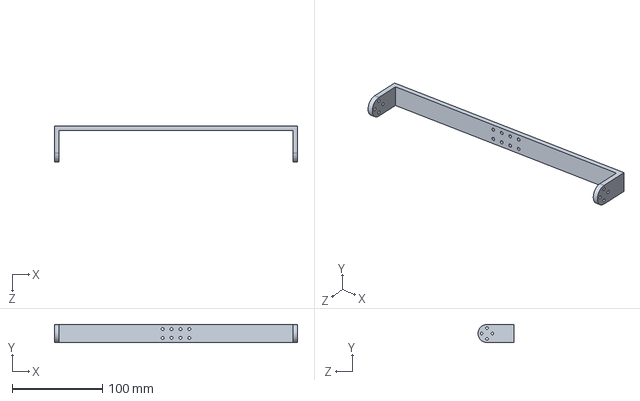
[picture p67: CAD file, 2026-11-09]
模型/长条手.SLDPRT
270.0 x 20.0 x 40.0 mm
