jounshenwang/land-air-robot/模型/圆柱齿轮23×1.SLDPRT

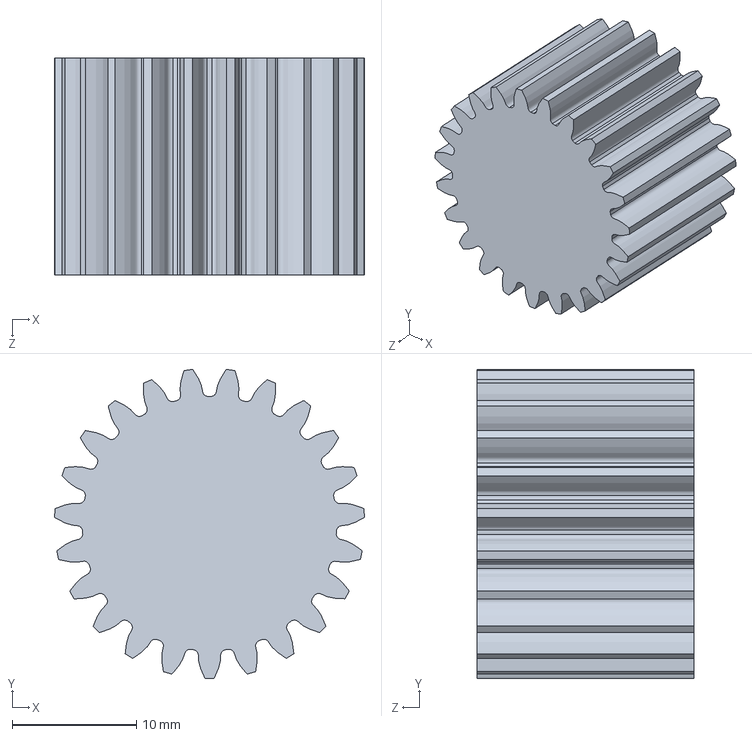
[picture p68: CAD file, 2026-11-09]
模型/圆柱齿轮23×1.SLDPRT
25.0 x 24.9 x 17.5 mm
