jounshenwang/land-air-robot/模型/手臂.SLDPRT

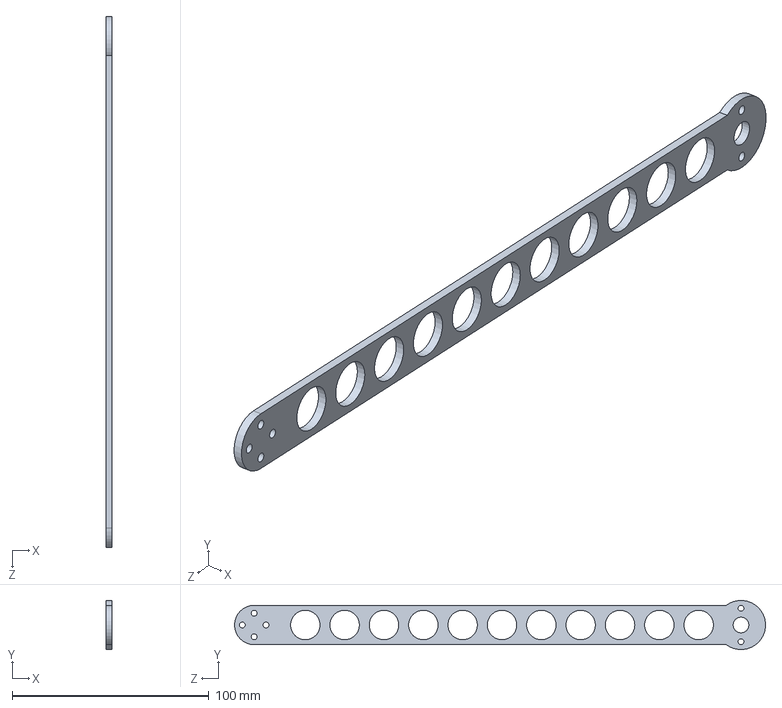
[picture p69: CAD file, 2026-11-09]
模型/手臂.SLDPRT
3.00 x 24.9 x 270.0 mm
