jounshenwang/land-air-robot/模型/胎皮.SLDPRT

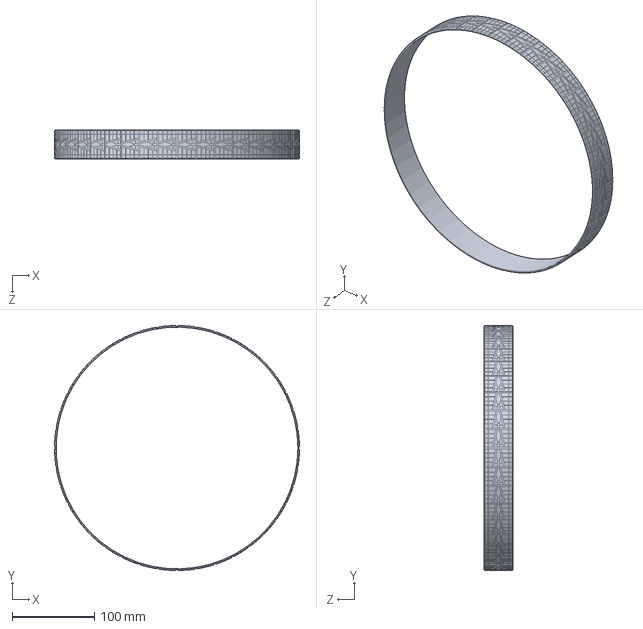
[picture p70: CAD file, 2026-11-09]
模型/胎皮.SLDPRT
298.0 x 298.0 x 35.0 mm
