jounshenwang/land-air-robot/模型/滚筒固定杆.SLDPRT

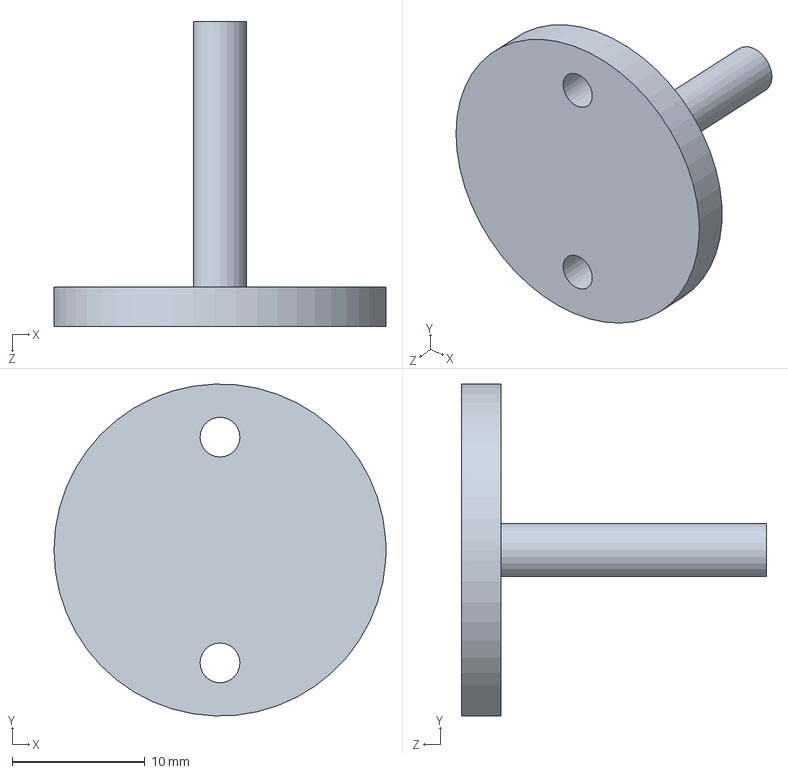
[picture p71: CAD file, 2026-11-09]
模型/滚筒固定杆.SLDPRT
25.0 x 25.0 x 23.0 mm
