jounshenwang/land-air-robot/模型/esp32.SLDPRT

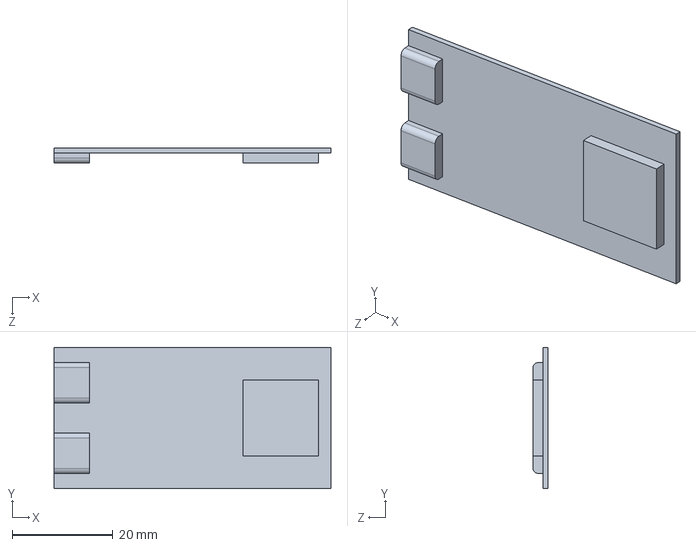
[picture p72: CAD file, 2026-11-09]
模型/esp32.SLDPRT
55.0 x 28.0 x 3.00 mm
