jounshenwang/land-air-robot/模型/分电板.SLDASM

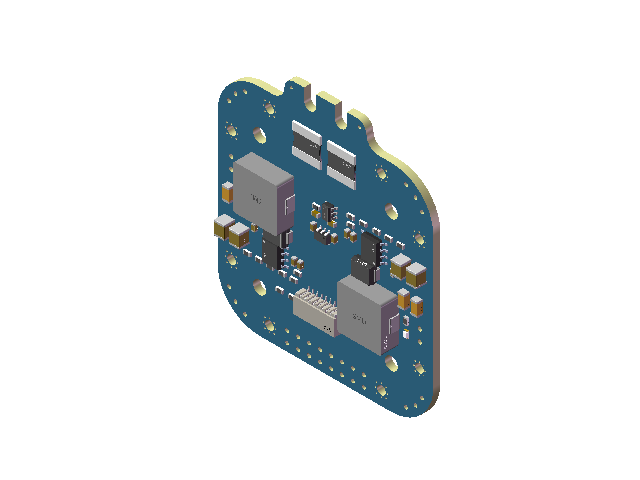
[picture p73: CAD file, 2026-11-09]
模型/分电板.SLDASM
SOLID.step x 8
SOLID-0.step x 2
SOLID-1.step x 4
SOLID-2.step x 4
SOLID-3.step x 2
COMPOUND.step
COMPOUND-4.step
COMPOUND-5.step x 18
SOLID-6.step x 2
COMPOUND-7.step x 2
COMPOUND-8.step x 2
COMPOUND-9.step
COMPOUND-10.step
SOLID-11.step
SOLID-12.step x 2
Board.step
