jounshenwang/land-air-robot/模型/清洁滚筒装配体.SLDASM

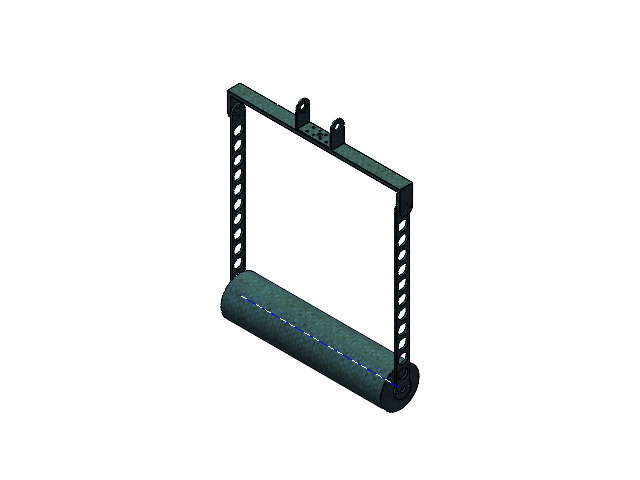
[picture p74: CAD file, 2026-11-09]
模型/清洁滚筒装配体.SLDASM
长条手
手臂 x 2
滚筒
滚筒固定杆
