jounshenwang/land-air-robot/模型/mid-360-asm.SLDASM

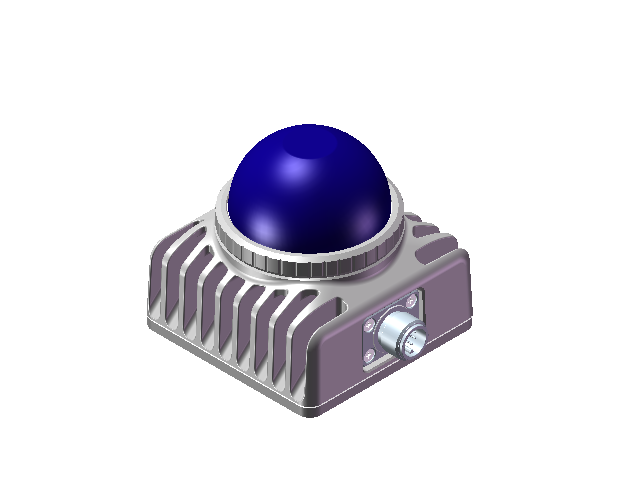
[picture p75: CAD file, 2026-11-09]
模型/mid-360-asm.SLDASM
MID-360_4_1.stp
MID-360_4_2.stp
MID-360_4_3.stp
MID-360_4_4.stp
MID-360_4_5.stp
MID-360_4_6.stp
MID-360_4_7.stp
MID-360_4_ASM.stp
