jounshenwang/land-air-robot/(list of files, cad)

Other CAD files:
模型/陆空两栖光伏清洁巡检机器人.SLDASM
模型/减震板_上板.SLDPRT
模型/分电板.SLDPRT
