jounshenwang/land-air-robot/thermal-monitoring/hik_capture.c

#include <stdio.h>
#include <stdlib.h>
#include <string.h>
#include <unistd.h>
#include <sys/types.h>
#include <unistd.h>
#include <signal.h>
#include <time.h>
#include <pthread.h>

#include "uvc_camera.h"

/* 调试信息全部走 stderr，保证 stdout 只有给 img.py 的二进制帧。 */
#define printf(...) fprintf(stderr, __VA_ARGS__)

typedef struct _condwait {
	pthread_mutex_t        mutx;
	pthread_cond_t         cond;
	volatile unsigned int  cwaiters;
	volatile int           cval;
} condwait_t;

#define VID       0x2bdf
#define PID       0x0102
#define VPSTR    "2bdf:0102"
#define find_hik_sensor(s)   (strstr(s, VPSTR) != NULL)

static pthread_t      hk_tid;
static volatile int   hik_run = 0;
int    width, height;
int    g_fps;
static uvc_t   g_uvc;

#define SAFE_EXIT()  do { \
	hk_tid = 0; \
	kill(getpid(), SIGTERM); \
	pthread_exit(NULL); \
} while (0)

extern int   hik_sensor_init(uvc_t *u);

void  msleep(unsigned int ms)
{
	struct timeval  tv;

	tv.tv_sec = ms/1000;
	tv.tv_usec = (ms%1000)*1000;
	select(0, NULL, NULL, NULL, &tv);
}

static int  my_system(const char *cmd, char *obuf, int size)
{
	FILE  *fp;

	memset(obuf, 0, size);
	fp = popen(cmd, "r");
	if (fp) {
		int   n;
		n = fread(obuf, 1, size, fp);
		if (n >= 0)
			obuf[n] = 0;
		pclose(fp);
		return n;
	}

	return -1;
}

static void  condwait_init(condwait_t *cw)
{
	pthread_condattr_t cndattr;
	memset(cw, 0, sizeof(condwait_t));
	pthread_mutex_init(&cw->mutx, NULL);
	pthread_condattr_init(&cndattr);
	pthread_condattr_setclock(&cndattr, CLOCK_MONOTONIC);
	pthread_cond_init(&cw->cond, &cndattr);
	pthread_condattr_destroy(&cndattr);
}

static int   condwait_wait(condwait_t *cw)
{
	int  v;

	pthread_mutex_lock(&cw->mutx);
	++cw->cwaiters;
	while (cw->cval == 0)
		pthread_cond_wait(&cw->cond, &cw->mutx);
	--cw->cwaiters;
	v = cw->cval;
	pthread_mutex_unlock(&cw->mutx);

	return v;
}

static int  condwait_signal(condwait_t *cw, int v)
{
	int  ov;

	pthread_mutex_lock(&cw->mutx);
	ov = cw->cval;
	if (cw->cval == 0) {
		cw->cval = v;
		if (cw->cwaiters > 0)
			pthread_cond_signal(&cw->cond);
	}
	pthread_mutex_unlock(&cw->mutx);

	return ov;
}

static void get_temperature(uint8_t *buf)
{
	/* we can do anything we want with temperature data here. */
}

/* 回调函数：将视频数据直接写入标准输出，传给 Python */
static void frame_cb(uvc_frame_t *frame, void *arg)
{
    uvc_t *u = (uvc_t *)arg;

    if (!hik_run) return;

    // 检查数据长度是否为协议规定的总长度 (201248 字节)
    if (frame == NULL || frame->data_bytes != u->size)
        return;

    /* * 【修正逻辑】
     * 不再使用 + u->offset，也不再只发送 u->len。
     * 直接发送从 frame->data 开始的全部 u->size 字节。
     */
    fwrite(frame->data, 1, u->size, stdout); 
    
    fflush(stdout);
}

static int  hik_capture_open(uvc_t *u)
{
	char  qstr[512];
	unsigned int  i = 0;

	while (1) {
		my_system("lsusb", qstr, sizeof(qstr));
		if (find_hik_sensor(qstr)) {
			printf("hik sensor found!\n");
			break;
		}

		if (i < 10) {
			printf("lsusb: %s\n", qstr);
			printf("hik sensor not found!\n");
		}
		++i;
		msleep(1000);
	}

	if (uvc_camera_open(u, VID, PID) == 0) {
		printf("--- hik_sensor_open successfully ---\n");
		return 0;
	}
	return -1;
}

static int  hik_capture_init(uvc_t *u, int *w, int *h)
{
	if (hik_sensor_init(u) != 0) {
		printf("hik sensor init failed!\n");
		return -1;
	}

	uvc_set_video_mode(u, w, h, &g_fps);

	width = *w;
	height = *h;

	return 0;
}

static int  hik_capture_start(uvc_t *u)
{
	uvc_set_frame_callback(u, frame_cb);
	if (uvc_camera_start(u) != 0) {
		uvc_camera_close(u);
		printf("uvc_camera_start failed\n");
		return -1;
	}

	return 0;
}

static void  hik_capture_close(uvc_t *u)
{
	uvc_camera_close_stream(u);
	uvc_camera_close(u);
}

static condwait_t  h_cw;
static void  *hik_capture_loop(void *arg)
{
	uvc_t *u = (uvc_t *)arg;

	printf("hik sensor: w = %d, h = %d\n", width, height);
	u->fptr = malloc(width*height*2);

	condwait_wait(&h_cw);
	if (hik_capture_start(u) != 0)
		SAFE_EXIT();
	hik_run = 1;
	while (hik_run) {
		pause();
	}
	hik_capture_close(u);
	printf("--- hik_capture_loop quit! ---\n");

	free(u->fptr);
	u->fptr = NULL;

	pthread_exit(NULL);
}

void  prepare_hik_sensor(void)
{
	int  w, h;

	condwait_init(&h_cw);
	if (hik_capture_open(&g_uvc) != 0) {
		printf("hik_capture_open error and exit!\n");
		exit(EXIT_FAILURE);
	}

	if (hik_capture_init(&g_uvc, &w, &h) != 0) {
		printf("hik_capture_init error and exit!\n");
		exit(EXIT_FAILURE);
	}

	pthread_create(&hk_tid, NULL, hik_capture_loop, (void *)&g_uvc);
}

void  start_hik_sensor(void)
{
	condwait_signal(&h_cw, 1);
}

void  stop_hik_sensor(void)
{
	hik_run = 0;
	if (hk_tid > 0) {
		pthread_kill(hk_tid, SIGINT);
		pthread_join(hk_tid, NULL);
		printf("hik sensor loop exit!\n");
	}
}
