jounshenwang/land-air-robot/(notices)

Notices in the files:
README.md:
License: MIT
